El-Luhb/nvme-Carrier-for-LattePanda-Mu/README.md

# nvme Carrier for LattePanda Mu

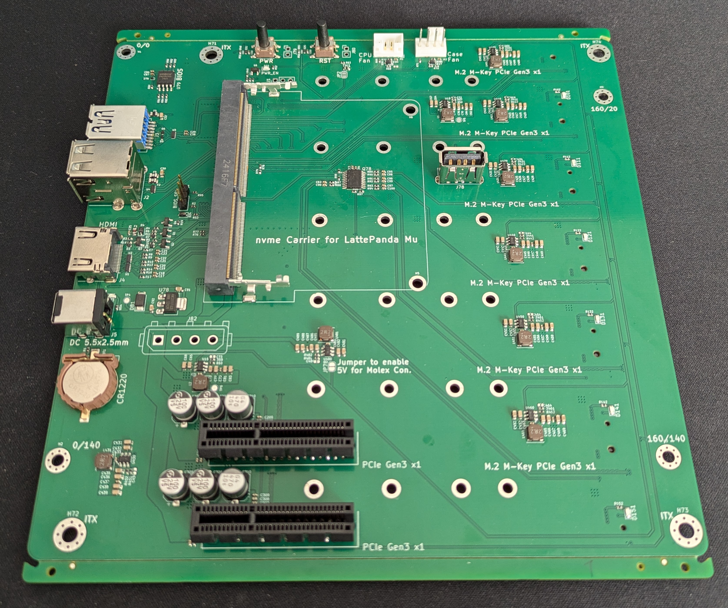
[picture p1: 1_front.jpg]


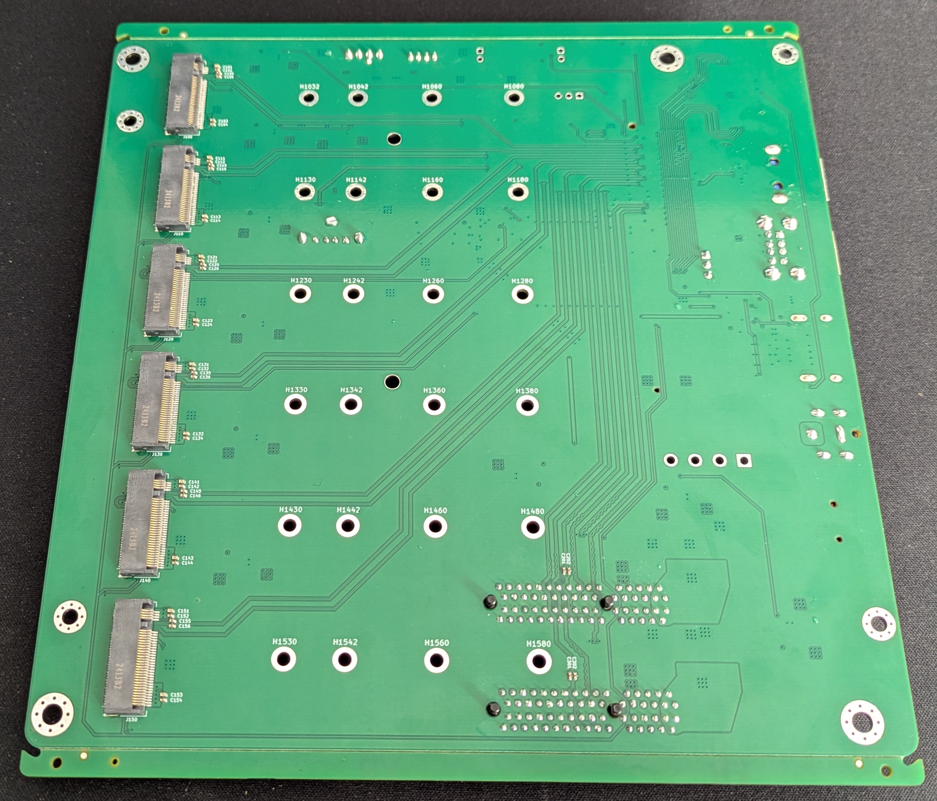
[picture p2: 1_back.jpg]
