El-Luhb/nvme-Carrier-for-LattePanda-Mu/nvme Carrier Case.STL

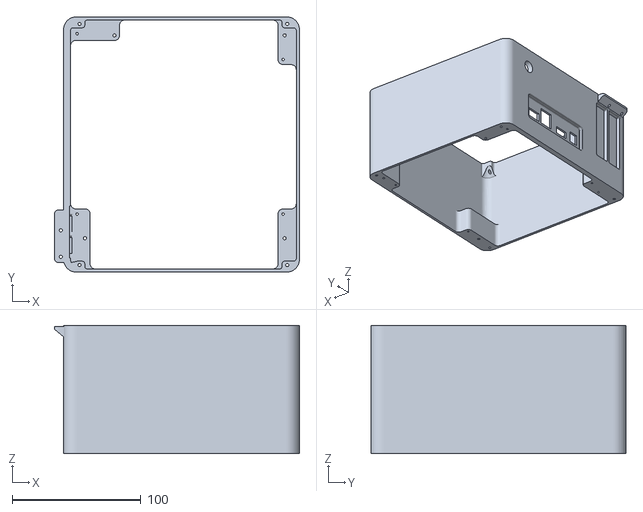
[picture p5: CAD file, 2024-12-30]
nvme Carrier Case.STL
190.2 x 198.2 x 99.5
