El-Luhb/nvme-Carrier-for-LattePanda-Mu/nvme Carrier Case Top.STL

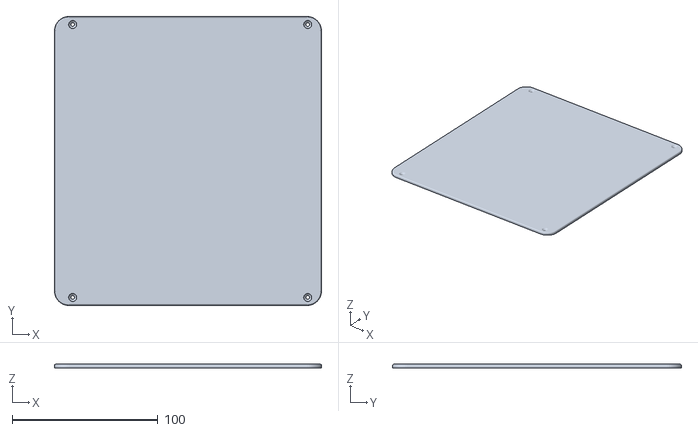
[picture p6: CAD file, 2024-12-30]
nvme Carrier Case Top.STL
183.2 x 198.2 x 2.50
