El-Luhb/nvme-Carrier-for-LattePanda-Mu/nvme Carrier Case Bottom.STL

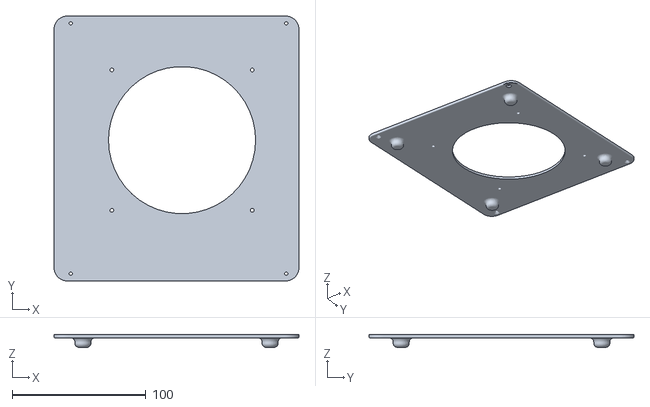
[picture p7: CAD file, 2024-12-30]
nvme Carrier Case Bottom.STL
183.2 x 198.2 x 9.50
