El-Luhb/nvme-Carrier-for-LattePanda-Mu/(threads)

Thread 1 (2024-06-23):

BIOS

El-Luhb, 2024-06-23:
need BIOS file

El-Luhb, 2024-09-19:
HSIO Lanes need to be:
- HSIO0: USB3.2 10Gbps paired with USB2 P1 (only USB 2.0 Devices work)
- HSIO1: PCIe 3.0 x1 M.2 M Key (RefClk3)
- HSIO2: PCIe 3.0 x1 M.2 M Key (RefClk4) (works with normal BIOS)
- HSIO3: PCIe 3.0 x1 M.2 M Key (Buffer0) (works with normal BIOS)
- HSIO8: PCIe 3.0 x1 M.2 M Key (Buffer1) (works with normal BIOS)
- HSIO9: PCIe 3.0 x1 M.2 M Key (Buffer2)
- HSIO10: PCIe 3.0 x1 M.2 M Key (Buffer3)
- HSIO11: PCIe 3.0 x1 (RefClk1)
- HSIO6: PCIe 3.0 x1 (RefClk0) (works with normal BIOS)

El-Luhb, 2024-09-20:
Strange behavior of the system. If all ports (including the PCIe) are occupied with nvme SSDs, 4 are recognized. However, if only one is used at a time, it is not recognized on any port.
If only the 4 ports are used that were running when fully populated, only 2 are recognized.

El-Luhb, 2024-09-22:
I tested the BIOS on the Lite Carrier. Everything works normally. Even both USB3 ports.
It seems that the configuration was not applied correctly.

El-Luhb, 2024-09-25:
Was now able to install the BIOS on the carrier (new chips, as the first ones were accidentally bricked).
Now all lanes are working. However, the USB3 prot still causes problems and if PCIe lane 6 is not occupied, PCIe lane 2 does not work. There may be other combinations that cause problems. I will test this.
It seems that a custom BIOS cannot easily be installed on the Mu itself without causing errors. At least in the configuration I need here.

alphaarea, 2024-09-30:
[LP-BS-S70NC1R200-SR-B-El-Luhb-20240930.zip](https://github.com/user-attachments/files/17187610/LP-BS-S70NC1R200-SR-B-El-Luhb-20240930.zip)

A new BIOS file has been created for you, please try to see if it works properly, and it contains a new BIOS update program.

If you already have a CH341A programmer, you can ignore the attached update utility and use the CH341A to flash the BIOS file directly into the ROM.

No matter how to update, you should completely disconnect the power supply and RTC battery to restore the BIOS default settings after the update is finished.

In addition, according to my personal test, there are some cases that after the BIOS update is completed, you need to reboot the system again to recognize the new BIOS port configuration, i.e., PCIe, USB and other port configurations correctly. The reason is unknown.

----------

If possible, please attach the actual device you are installing and the PCIe bus info in system so that we can further analyze the problem.

Use `lspci` for Linux, HWiNFO is recommended for Windows to generate hardware reports.

El-Luhb, 2024-09-30:
Thank you for the new BIOS.
Not all SSDs are recognized on the new BIOS ver. B.
Nothing was recognized at the USB 3.x port on both. I'll probably have to check the solder contacts here.
I have started my board with the same (full) configuration with both BIOS.

Here is the output from `lspci`:
BIOS ver. A:
```
root@Tower:~# lspci
00:00.0 Host bridge: Intel Corporation Device 461c
00:02.0 VGA compatible controller: Intel Corporation Alder Lake-N [UHD Graphics]
00:0a.0 Signal processing controller: Intel Corporation Platform Monitoring Technology (rev 01)
00:0d.0 USB controller: Intel Corporation Device 464e
00:14.0 USB controller: Intel Corporation Device 54ed
00:14.2 RAM memory: Intel Corporation Device 54ef
00:15.0 Serial bus controller: Intel Corporation Device 54e8
00:15.2 Serial bus controller: Intel Corporation Device 54ea
00:15.3 Serial bus controller: Intel Corporation Device 54eb
00:16.0 Communication controller: Intel Corporation Device 54e0
00:19.0 Serial bus controller: Intel Corporation Device 54c5
00:19.1 Serial bus controller: Intel Corporation Device 54c6
00:1a.0 SD Host controller: Intel Corporation Device 54c4
00:1c.0 PCI bridge: Intel Corporation Device 54b9
00:1c.2 PCI bridge: Intel Corporation Device 54ba
00:1c.3 PCI bridge: Intel Corporation Device 54bb
00:1c.6 PCI bridge: Intel Corporation Device 54be
00:1d.0 PCI bridge: Intel Corporation Device 54b0
00:1d.1 PCI bridge: Intel Corporation Device 54b1
00:1d.2 PCI bridge: Intel Corporation Device 54b2
00:1d.3 PCI bridge: Intel Corporation Device 54b3
00:1f.0 ISA bridge: Intel Corporation Device 5481
00:1f.4 SMBus: Intel Corporation Device 54a3
00:1f.5 Serial bus controller: Intel Corporation Device 54a4
01:00.0 Non-Volatile memory controller: Kingston Technology Company, Inc. A2000 NVMe SSD SM2263EN (rev 03)
02:00.0 Non-Volatile memory controller: Samsung Electronics Co Ltd NVMe SSD Controller PM9A1/PM9A3/980PRO
03:00.0 Non-Volatile memory controller: KIOXIA Corporation NVMe SSD (rev 01)
04:00.0 Ethernet controller: Intel Corporation Ethernet Controller I226-V (rev 04)
05:00.0 Non-Volatile memory controller: KIOXIA Corporation NVMe SSD (rev 01)
06:00.0 Non-Volatile memory controller: Kingston Technology Company, Inc. A2000 NVMe SSD SM2263EN (rev 03)
07:00.0 Non-Volatile memory controller: Kingston Technology Company, Inc. A2000 NVMe SSD SM2263EN (rev 03)
08:00.0 PCI bridge: ASMedia Technology Inc. ASM1182e 2-Port PCIe x1 Gen2 Packet Switch
09:03.0 PCI bridge: ASMedia Technology Inc. ASM1182e 2-Port PCIe x1 Gen2 Packet Switch
09:07.0 PCI bridge: ASMedia Technology Inc. ASM1182e 2-Port PCIe x1 Gen2 Packet Switch
0a:00.0 Ethernet controller: Realtek Semiconductor Co., Ltd. RTL8125 2.5GbE Controller (rev 05)
0b:00.0 Ethernet controller: Realtek Semiconductor Co., Ltd. RTL8125 2.5GbE Controller (rev 05)
```

BIOS ver. B:
```
root@Tower:~# lspci
00:00.0 Host bridge: Intel Corporation Device 461c
00:02.0 VGA compatible controller: Intel Corporation Alder Lake-N [UHD Graphics]
00:0a.0 Signal processing controller: Intel Corporation Platform Monitoring Technology (rev 01)
00:0d.0 USB controller: Intel Corporation Device 464e
00:14.0 USB controller: Intel Corporation Device 54ed
00:14.2 RAM memory: Intel Corporation Device 54ef
00:15.0 Serial bus controller: Intel Corporation Device 54e8
00:15.1 Serial bus controller: Intel Corporation Device 54e9
00:15.2 Serial bus controller: Intel Corporation Device 54ea
00:15.3 Serial bus controller: Intel Corporation Device 54eb
00:16.0 Communication controller: Intel Corporation Device 54e0
00:19.0 Serial bus controller: Intel Corporation Device 54c5
00:19.1 Serial bus controller: Intel Corporation Device 54c6
00:1a.0 SD Host controller: Intel Corporation Device 54c4
00:1c.0 PCI bridge: Intel Corporation Device 54b9
00:1c.2 PCI bridge: Intel Corporation Device 54ba
00:1c.3 PCI bridge: Intel Corporation Device 54bb
00:1c.6 PCI bridge: Intel Corporation Device 54be
00:1d.0 PCI bridge: Intel Corporation Device 54b0
00:1d.1 PCI bridge: Intel Corporation Device 54b1
00:1d.2 PCI bridge: Intel Corporation Device 54b2
00:1d.3 PCI bridge: Intel Corporation Device 54b3
00:1f.0 ISA bridge: Intel Corporation Device 5481
00:1f.4 SMBus: Intel Corporation Device 54a3
00:1f.5 Serial bus controller: Intel Corporation Device 54a4
02:00.0 Non-Volatile memory controller: Samsung Electronics Co Ltd NVMe SSD Controller PM9A1/PM9A3/980PRO
03:00.0 Non-Volatile memory controller: KIOXIA Corporation NVMe SSD (rev 01)
04:00.0 Ethernet controller: Intel Corporation Ethernet Controller I226-V (rev 04)
05:00.0 Non-Volatile memory controller: KIOXIA Corporation NVMe SSD (rev 01)
08:00.0 PCI bridge: ASMedia Technology Inc. ASM1182e 2-Port PCIe x1 Gen2 Packet Switch
09:03.0 PCI bridge: ASMedia Technology Inc. ASM1182e 2-Port PCIe x1 Gen2 Packet Switch
09:07.0 PCI bridge: ASMedia Technology Inc. ASM1182e 2-Port PCIe x1 Gen2 Packet Switch
0a:00.0 Ethernet controller: Realtek Semiconductor Co., Ltd. RTL8125 2.5GbE Controller (rev 05)
0b:00.0 Ethernet controller: Realtek Semiconductor Co., Ltd. RTL8125 2.5GbE Controller (rev 05)
```

El-Luhb, 2024-10-01:
some more logs.
file name --> a.ssd.1.8.net.11 --> BIOS ver. A . SSDs on HSIO 1 and 8 . Networkcard on HSIO 11
In b.ssd.1.2.3.8.9.10.net.6.11 none v2, I set the option ASPM to Auto. in the v2 it wase on Disabled (Default).
Hardware I used:
for the test with two SSDs (both Samsung PM981a) Networkcard: Noname Intel I226
Full use:
HSIO 1  - Kingston A2000
HSIO 2  - Samsung PM9A1
HSIO 3  - KIOXIA Exceris G2
HSIO 6  - Intel I226
HSIO 8  - KIOXIA Exceris G2
HSIO 9  - Kingston A2000
HSIO 10 - Kingston A2000
HSIO 11 - Networkcard with two RTL8125 (PCIe Splitter: ASM1182e)

[a.ssd.1.2.3.8.9.10.net.6.11.txt](https://github.com/user-attachments/files/17204140/a.ssd.1.2.3.8.9.10.net.6.11.txt)
[a.ssd.1.8.net.11.txt](https://github.com/user-attachments/files/17204141/a.ssd.1.8.net.11.txt)
[a.ssd.2.9.net.6.txt](https://github.com/user-attachments/files/17204143/a.ssd.2.9.net.6.txt)
[a.ssd.2.9.net.11.txt](https://github.com/user-attachments/files/17204144/a.ssd.2.9.net.11.txt)
[b.ssd.1.2.3.8.9.10.net.6.11.txt](https://github.com/user-attachments/files/17204145/b.ssd.1.2.3.8.9.10.net.6.11.txt)
[b.ssd.1.2.3.8.9.10.net.6.11-v2.txt](https://github.com/user-attachments/files/17204146/b.ssd.1.2.3.8.9.10.net.6.11-v2.txt)
[b.ssd.1.8.net.11.txt](https://github.com/user-attachments/files/17204147/b.ssd.1.8.net.11.txt)
[b.ssd.2.9.net.6.txt](https://github.com/user-attachments/files/17204148/b.ssd.2.9.net.6.txt)
[b.ssd.2.9.net.11.txt](https://github.com/user-attachments/files/17204149/b.ssd.2.9.net.11.txt)

Hope there is somethig to find here.
I don't have much time in the moment :(

alphaarea, 2024-10-14:
It looks like the PCIe ports are all recognized, is the SSD and NIC all working fine?

Also, do you mind if we make a few samples to promote LattePanda Mu?

El-Luhb, 2024-10-14:
Yes, all PCIe ports work, but not in all combinations, e.g. if HSIO 2 and 9 are used with an SSD and HSIO 11 with a NIC, only the NIC is recognized (under default settings).
I am currently playing with the BIOS settings to find possible problems.
And the USB 3.x port does not yet work.
If the PCIe devices are recognized, they reach the expected performance.

And I would be very happy if you would create and use samples of my project.

El-Luhb, 2024-10-16:
I experimented a bit and now it seems that more combinations of M.2 mounting work. At least I haven't found one that doesn't work.
What I have done:
- Removed R78 and R79
- Set PCIe clocks to:
```
Clock0 assignment -> Platform-POR
Clock1 assignment -> Enabled
Clock2 assignment -> Enabled
Clock3 assignment -> Enabled
ClkReq for Clock3 -> Platform-POR
Clock4 assignment -> Enabled
ClkReq for Clock4 -> Platform-POR
```

elshadpb, 2025-01-29:
Hi, how is your progress? As I know N100 CPU support only 5 PCIe device. So per device for per line may not work, am I right?
P.S. I also want to create my own carrier board. So I want to learn from your practice

El-Luhb, 2025-01-29:
The system runs (almost without problems) with up to 8 PCIe devices.
The limitation of 5 devices refers to the standard BIOS and the available CLK lanes.
With the help of a CLK buffer IC (9DBL411BGLFT on this carrier), it is possible to extend the CLK lanes. What is then also important is an adjusted BIOS in which the PCIe lanes are divided up accordingly.

elshadpb, 2025-01-29:
Thanks for explanation

elshadpb, 2025-01-30:
Can I ask from where you got BIOS for your board? Are you developed your own BIOS?

El-Luhb, 2025-01-30:
I got the BIOS from alphaarea. see [above](https://github.com/El-Luhb/nvme-Carrier-for-LattePanda-Mu/issues/1#issuecomment-2382645719).
You can request a BIOS by sending specific configuration requirements to [techsupport@lattepanda.com](mailto:techsupport@lattepanda.com)

elshadpb, 2025-01-30:
@El-Luhb
I want board with 1xUSB3, 1xNIC2.5, 2xSATA, 1xM.2-E(x1), 2xM.2-M(x2). Total 9 PCI lanes.
As I understand from your board USB2 do not need PCIe lanes.
As I am absolute noob in electronics I want to adapt your board or will use your board and use M.2-NIC, M.2-SATA adapters.
You are doing great work.

El-Luhb, 2025-02-02:
@elshadpb
And yes, the USB2.0 connections are available separately.
That's the reason why I designed this board the way I did. For example, a SATA extension in the upper PCIe slot and Ethernet in the lower slot.

El-Luhb, 2025-02-02:
The USB 3.x port works with a correspondingly correcting cable.
The error was swapped connections. These have been corrected as of v1.0.

The latest BIOS provided by alphaarea ([Link](https://github.com/El-Luhb/nvme-Carrier-for-LattePanda-Mu/issues/1#issuecomment-2382645719))  is operational and so far stable for me.
Unfortunately ASPM does not work there yet (at least not for me).

Closed 2025-02-02.

Thread 4 (2024-06-23):

M.2 Size of Mounting holes correct?

El-Luhb, 2024-06-23:

Closed 2024-09-19.

Thread 7 (2024-09-19):

Ground Pin internal USB and MountingPin PCIe Connectros

El-Luhb, 2024-09-19:
Ground Pin of the internal USB hits the M.2 SSD #1 and the MountingPin of the PCIe Connectros hits the M.2 SSD #5
#0, #2, #3, #4 fits

Thread 10 (2024-12-13):

Question: Does kicad has something like area rules to reuse layout of submodules?

konosubakonoakua, 2024-12-13:
just a wonder, because I have used this functionality in Altium.
Have you use same functionality in kicad? thank your answer in advance😊

El-Luhb, 2024-12-14:
Yes, there are some options for this. But I didn't use them. The reason for this was simply that I didn't have the time to find out how it works. For me, it was enough to just copy and paste.

konosubakonoakua, 2024-12-17:
Thank you.

Closed 2024-12-17.
