El-Luhb/nvme-Carrier-for-LattePanda-Mu/PCB/4 Layer nvme Carrier all M2/BIOS.kicad_sch

## KiCad design PCB/4 Layer nvme Carrier all M2/BIOS.kicad_sch (2025-02-06)

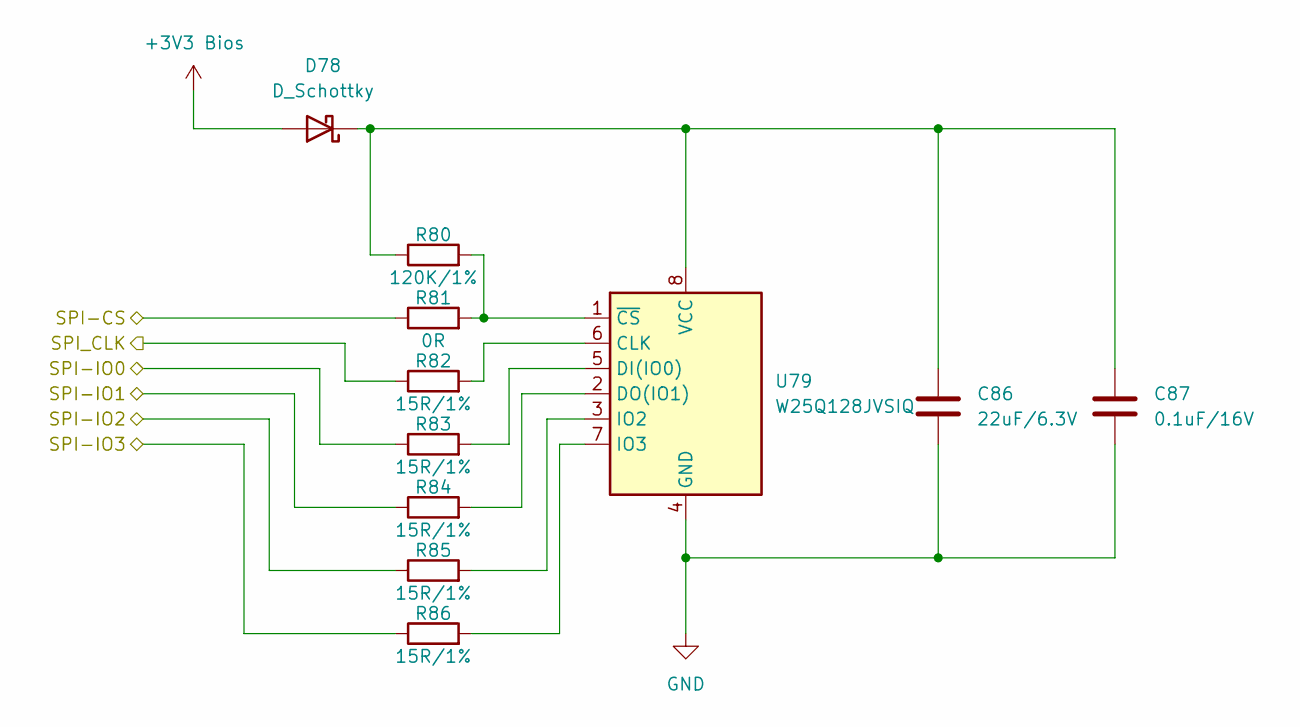
[picture p18: schematic BIOS.kicad_sch]

Parts:
C86: 22uF/6.3V; C_0402_1005Metric; Part# C105226; LCSC Part # C105226
C87: 0.1uF/16V; C_0402_1005Metric; Part# C83056; LCSC Part # C83056
D78: D_Schottky; D_SOD-923; Part# C239637; LCSC Part # C239637
R80: 120K/1%; R_0402_1005Metric; Part# C93945; LCSC Part # C93945
R81: 0R; R_0402_1005Metric; Part# C325377; LCSC Part # C325377
R82, R83, R84, R85, R86: 15R/1%; R_0402_1005Metric; Part# C138052; LCSC Part # C138052
U79: W25Q128JVSIQ; SOIC-8_5.23x5.23mm_P1.27mm; Part# C97521; LCSC Part # C97521

Connections:
+3V3 Bios: D78.2 (A)
GND: C86.2, C87.2, U79.4 (GND)
unnamed: C86.1, C87.1, D78.1 (K), R80.1, U79.8 (VCC)
unnamed: R80.2, R81.2, U79.1 (~CS)
unnamed: R82.2, U79.6 (CLK)
unnamed: R83.2, U79.5 (DI(IO0))
unnamed: R84.2, U79.2 (DO(IO1))
unnamed: R85.2, U79.3 (IO2)
unnamed: R86.2, U79.7 (IO3)
SPI-CS: R81.1
SPI-IO0: R83.1
SPI-IO1: R84.1
SPI-IO2: R85.1
SPI-IO3: R86.1
SPI_CLK: R82.1
