El-Luhb/nvme-Carrier-for-LattePanda-Mu/PCB/4 Layer nvme Carrier all M2/HDMI DP.kicad_sch

## KiCad design PCB/4 Layer nvme Carrier all M2/HDMI DP.kicad_sch (2025-02-06)

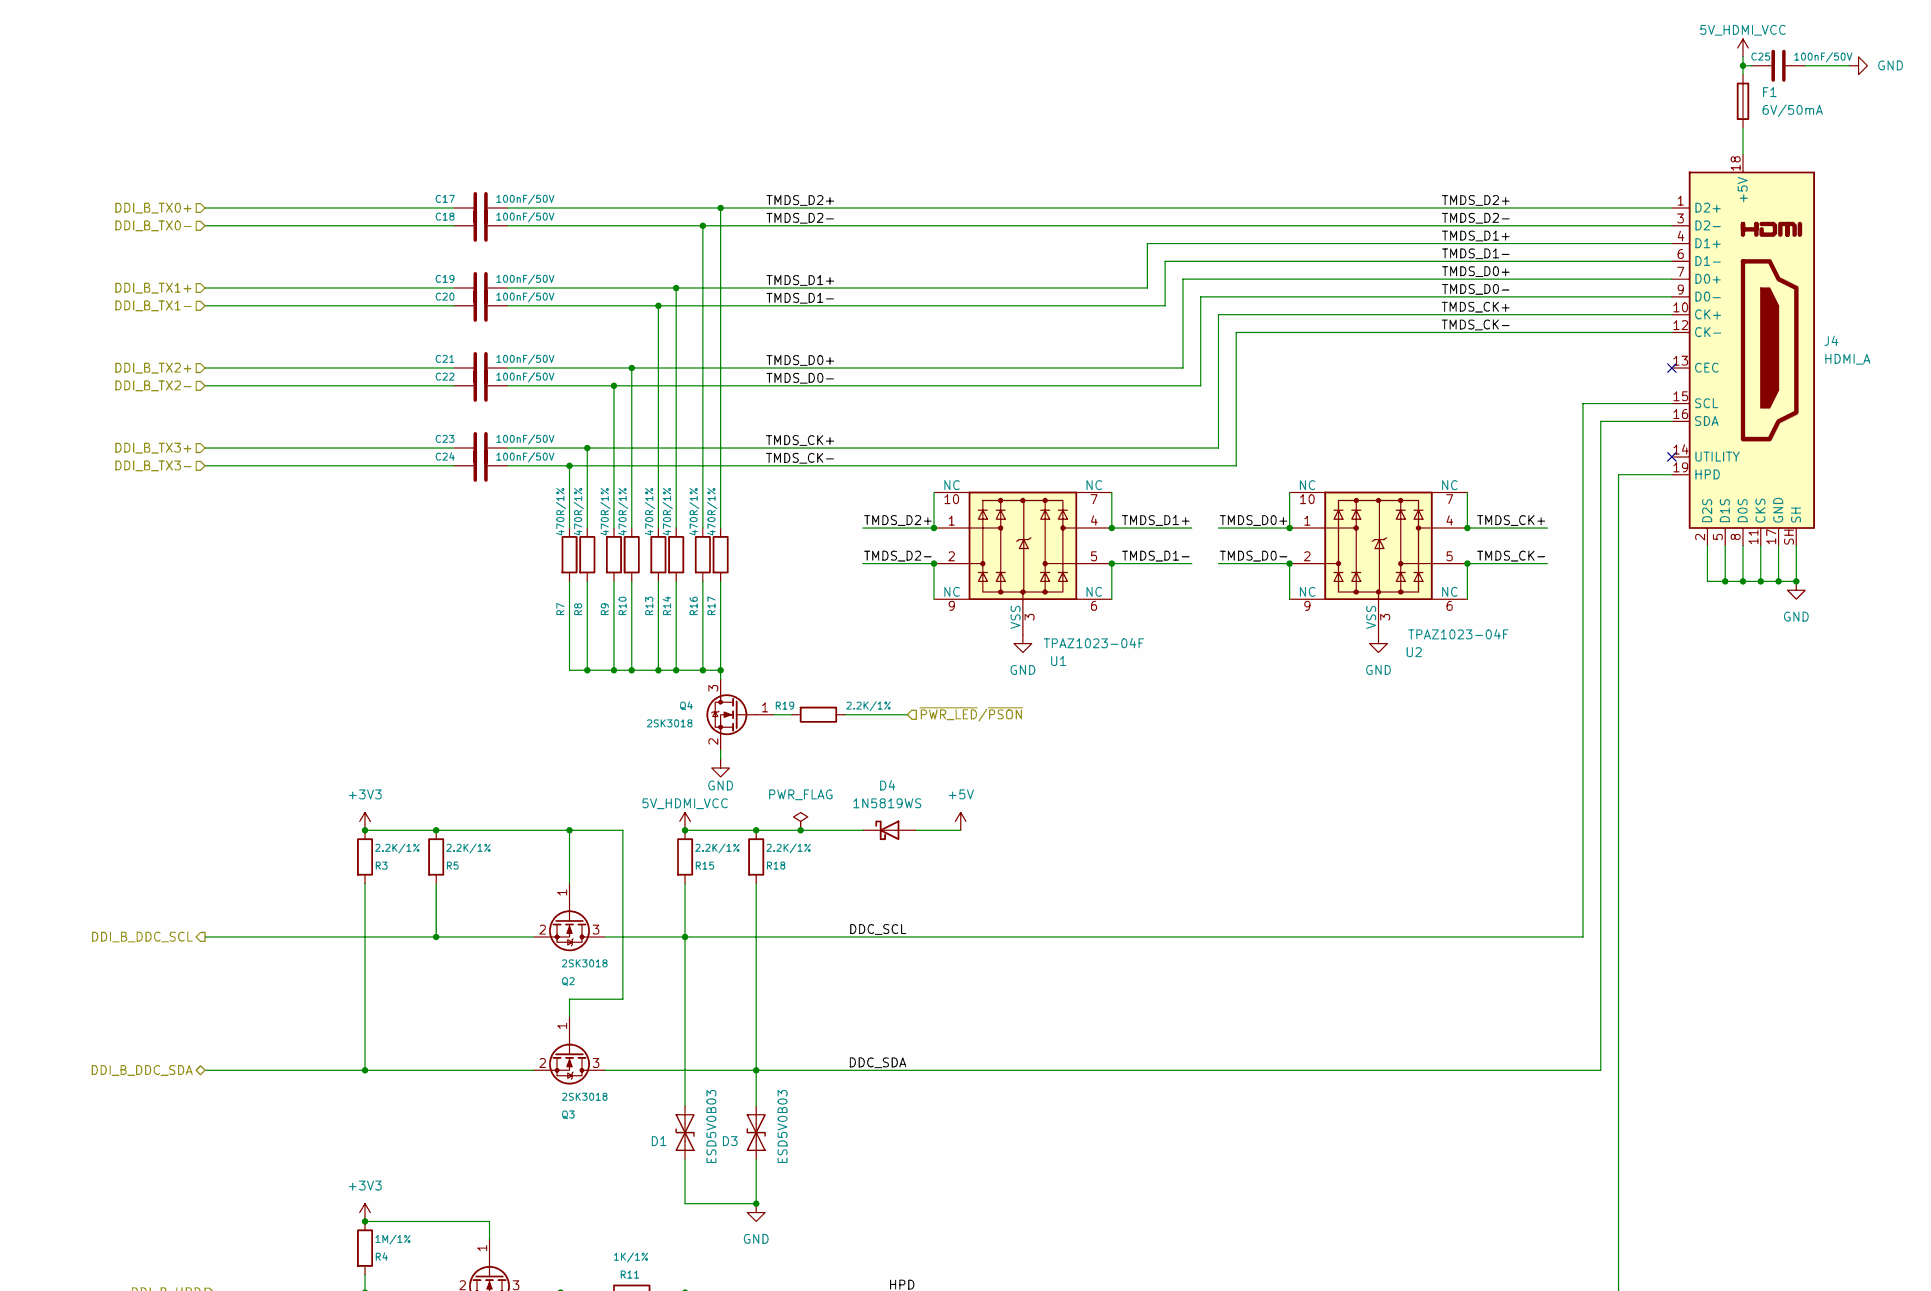
[picture p20: schematic HDMI DP.kicad_sch, part in row 1, column 1]

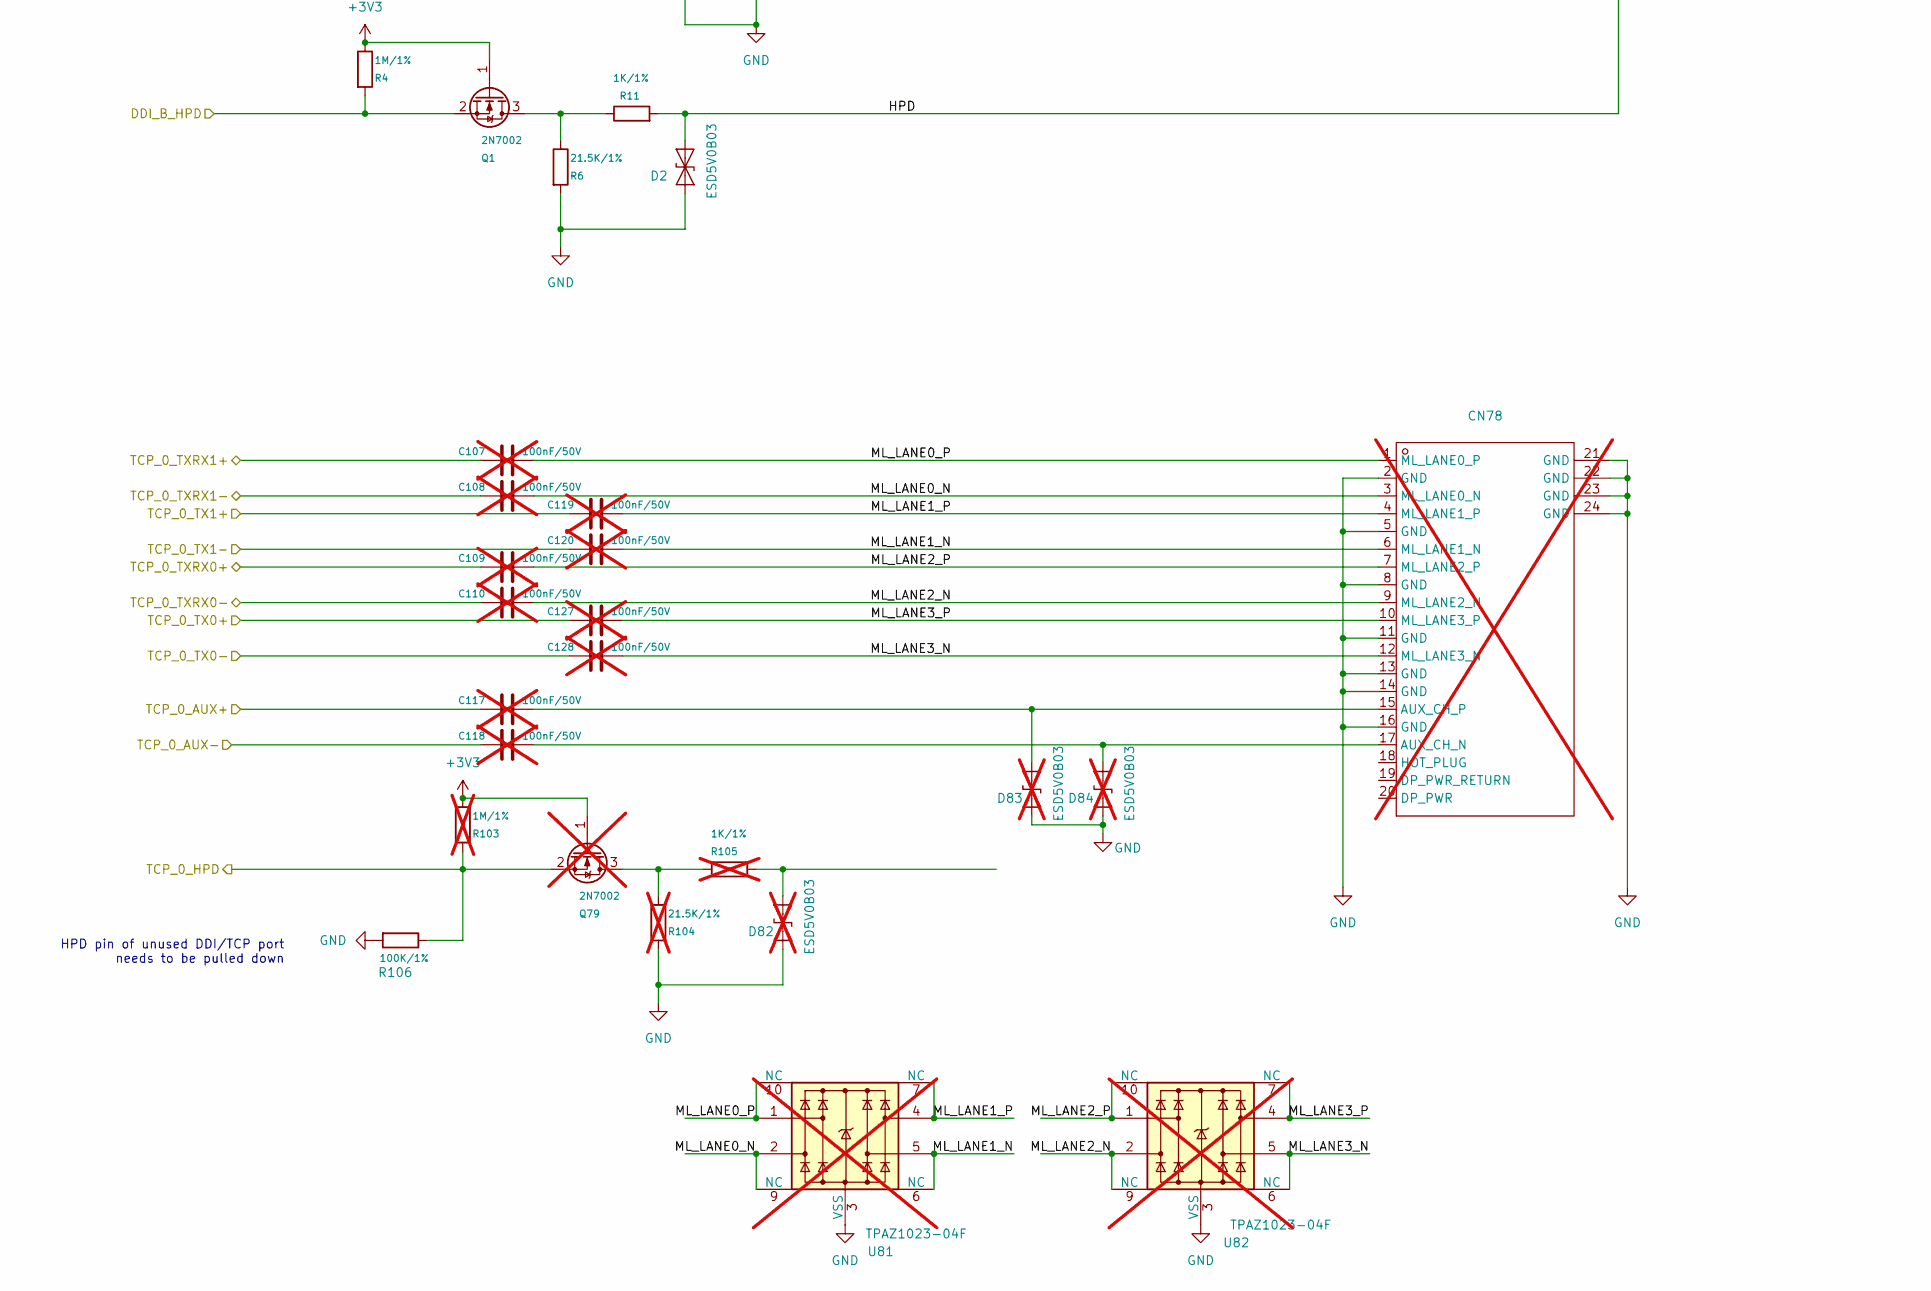
[picture p21: schematic HDMI DP.kicad_sch, part in row 2, column 1]

Parts:
C17, C18, C19, C20, C21, C22, C23, C24, C25: 100nF/50V; C_0402_1005Metric; Part# C77020; LCSC Part # C77020
C107, C108, C109, C110, C117, C118, C119, C120, C127, C128: 100nF/50V; C_0402_1005Metric; Part# C77020; LCSC Part # C77020; not fitted
CN78: DP-SMD_HYC16-DP20-178; Manufacturer Part HYC16-DP20-178; LCSC Part Name HYC16-DP20-178; not fitted
D1, D2, D3: ESD5V0B03; D_0402_1005Metric; Part# C521894; LCSC Part # C521894
D4: 1N5819WS; D_SOD-323; Part# C2828425; LCSC Part # C2828425
D82, D83, D84: ESD5V0B03; D_0402_1005Metric; Part# C521894; LCSC Part # C521894; not fitted
F1: 6V/50mA; R_0603_1608Metric; Part# C7472536; LCSC Part # C7472536
J4: HDMI_A; HDMI_A_Molex_208658-1001_Horizontal; Part# C916313; LCSC Part # C2858275
Q1: 2N7002; SOT-23; Part# C7603342; LCSC Part # C7603342
Q2, Q3, Q4: 2SK3018; SOT-23; Part# C475593; LCSC Part # C475593
Q79: 2N7002; SOT-23; Part# C7603342; LCSC Part # C7603342; not fitted
R3, R5, R15, R18, R19: 2.2K/1%; R_0402_1005Metric; Part# C114762; LCSC Part # C114762
R4: 1M/1%; R_0402_1005Metric; Part# C138033; LCSC Part # C138033
R6: 21.5K/1%; R_0402_1005Metric; Part# C185442; LCSC Part # C185442
R7, R8, R9, R10, R13, R14, R16, R17: 470R/1%; R_0402_1005Metric; Part# C114877; LCSC Part # C114877
R11: 1K/1%; R_0402_1005Metric; Part# C106235; LCSC Part # C106235
R103: 1M/1%; R_0402_1005Metric; Part# C138033; LCSC Part # C138033; not fitted
R104: 21.5K/1%; R_0402_1005Metric; Part# C185442; LCSC Part # C185442; not fitted
R105: 1K/1%; R_0402_1005Metric; Part# C106235; LCSC Part # C106235; not fitted
R106: 100K/1%; R_0402_1005Metric; Part# C60491; LCSC Part # C60491
U1, U2: TPAZ1023-04F; Diodes_UDFN-10_1.0x2.5mm_P0.5mm; Part# C2827676; LCSC Part # C2827676
U81, U82: TPAZ1023-04F; Diodes_UDFN-10_1.0x2.5mm_P0.5mm; Part# C2827676; LCSC Part # C2827676; not fitted

Connections:
5V_HDMI_VCC: C25.1, D4.1 (K), F1.1, R15.1, R18.1
+3V3: Q1.1 (G), Q2.1 (G), Q3.1 (G), Q79.1 (G), R3.1, R4.1, R5.1, R103.1
+5V: D4.2 (A)
DDC_SCL: D1.2 (A2), J4.15 (SCL), Q2.3 (D), R15.2
DDC_SDA: D3.2 (A2), J4.16 (SDA), Q3.3 (D), R18.2
DDI_B_DDC_SCL: Q2.2 (S), R5.2
DDI_B_DDC_SDA: Q3.2 (S), R3.2
DDI_B_HPD: Q1.2 (S), R4.2
DDI_B_TX0+: C17.1
DDI_B_TX0-: C18.1
DDI_B_TX1+: C19.1
DDI_B_TX1-: C20.1
DDI_B_TX2+: C21.1
DDI_B_TX2-: C22.1
DDI_B_TX3+: C23.1
DDI_B_TX3-: C24.1
GND: C25.2, CN78.2 (GND), CN78.5 (GND), CN78.8 (GND), CN78.11 (GND), CN78.13 (GND), CN78.14 (GND), CN78.16 (GND), CN78.21 (GND), CN78.22 (GND), CN78.23 (GND), CN78.24 (GND), D1.1 (A1), D2.1 (A1), D3.1 (A1), D82.1 (A1), D83.1 (A1), D84.1 (A1), J4.2 (D2S), J4.5 (D1S), J4.8 (D0S), J4.11 (CKS), J4.17 (GND), J4.SH, Q4.2 (S), R6.2, R104.2, R106.2, U1.3 (VSS), U1.8 (VSS), U2.3 (VSS), U2.8 (VSS), U81.3 (VSS), U81.8 (VSS), U82.3 (VSS), U82.8 (VSS)
HPD: D2.2 (A2), J4.19 (HPD), R11.2
ML_LANE0_N: C108.2, CN78.3 (ML_LANE0_N), U81.2, U81.9 (NC)
ML_LANE0_P: C107.2, CN78.1 (ML_LANE0_P), U81.1, U81.10 (NC)
ML_LANE1_N: C120.2, CN78.6 (ML_LANE1_N), U81.5, U81.6 (NC)
ML_LANE1_P: C119.2, CN78.4 (ML_LANE1_P), U81.4, U81.7 (NC)
ML_LANE2_N: C110.2, CN78.9 (ML_LANE2_N), U82.2, U82.9 (NC)
ML_LANE2_P: C109.2, CN78.7 (ML_LANE2_P), U82.1, U82.10 (NC)
ML_LANE3_N: C128.2, CN78.12 (ML_LANE3_N), U82.5, U82.6 (NC)
ML_LANE3_P: C127.2, CN78.10 (ML_LANE3_P), U82.4, U82.7 (NC)
unnamed: C117.2, CN78.15 (AUX_CH_P), D83.2 (A2)
unnamed: C118.2, CN78.17 (AUX_CH_N), D84.2 (A2)
unnamed: D82.2 (A2), R105.2
unnamed: F1.2, J4.18 (+5V)
unnamed: Q1.3 (D), R6.1, R11.1
unnamed: Q4.1 (G), R19.2
unnamed: Q4.3 (D), R7.2, R8.2, R9.2, R10.2, R13.2, R14.2, R16.2, R17.2
unnamed: Q79.3 (D), R104.1, R105.1
TCP_0_AUX+: C117.1
TCP_0_AUX-: C118.1
TCP_0_HPD: Q79.2 (S), R103.2, R106.1
TCP_0_TX0+: C127.1
TCP_0_TX0-: C128.1
TCP_0_TX1+: C119.1
TCP_0_TX1-: C120.1
TCP_0_TXRX0+: C109.1
TCP_0_TXRX0-: C110.1
TCP_0_TXRX1+: C107.1
TCP_0_TXRX1-: C108.1
TMDS_CK+: C23.2, J4.10 (CK+), R8.1, U2.4, U2.7 (NC)
TMDS_CK-: C24.2, J4.12 (CK-), R7.1, U2.5, U2.6 (NC)
TMDS_D0+: C21.2, J4.7 (D0+), R10.1, U2.1, U2.10 (NC)
TMDS_D0-: C22.2, J4.9 (D0-), R9.1, U2.2, U2.9 (NC)
TMDS_D1+: C19.2, J4.4 (D1+), R14.1, U1.4, U1.7 (NC)
TMDS_D1-: C20.2, J4.6 (D1-), R13.1, U1.5, U1.6 (NC)
TMDS_D2+: C17.2, J4.1 (D2+), R17.1, U1.1, U1.10 (NC)
TMDS_D2-: C18.2, J4.3 (D2-), R16.1, U1.2, U1.9 (NC)
~PWR_LED/~PSON: R19.1

Notes on the sheet:
HPD pin of unused DDI/TCP port needs to be pulled down
