El-Luhb/nvme-Carrier-for-LattePanda-Mu/PCB/4 Layer nvme Carrier all M2/LattePanda Module.kicad_sch

## KiCad design PCB/4 Layer nvme Carrier all M2/LattePanda Module.kicad_sch (2025-02-06)

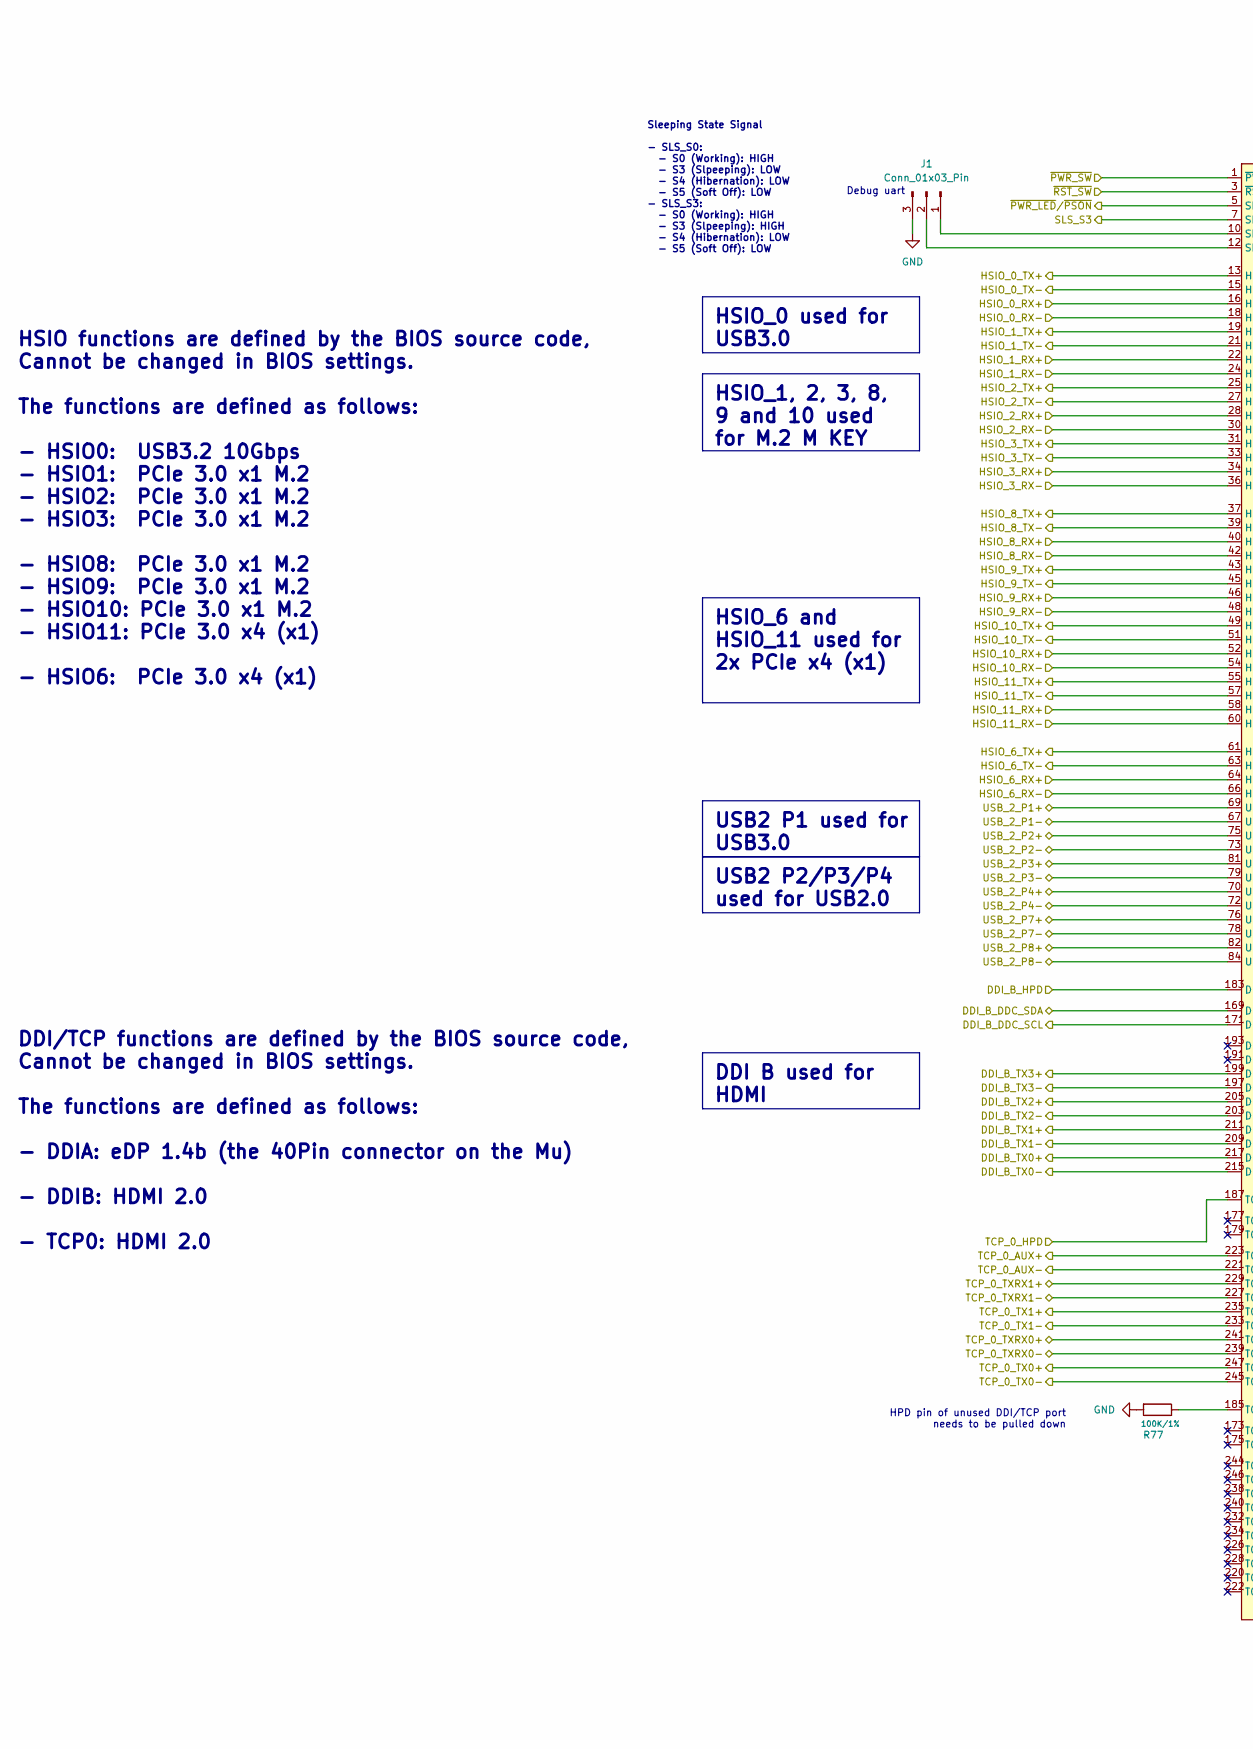
[picture p22: schematic LattePanda Module.kicad_sch, part in row 1, column 1]

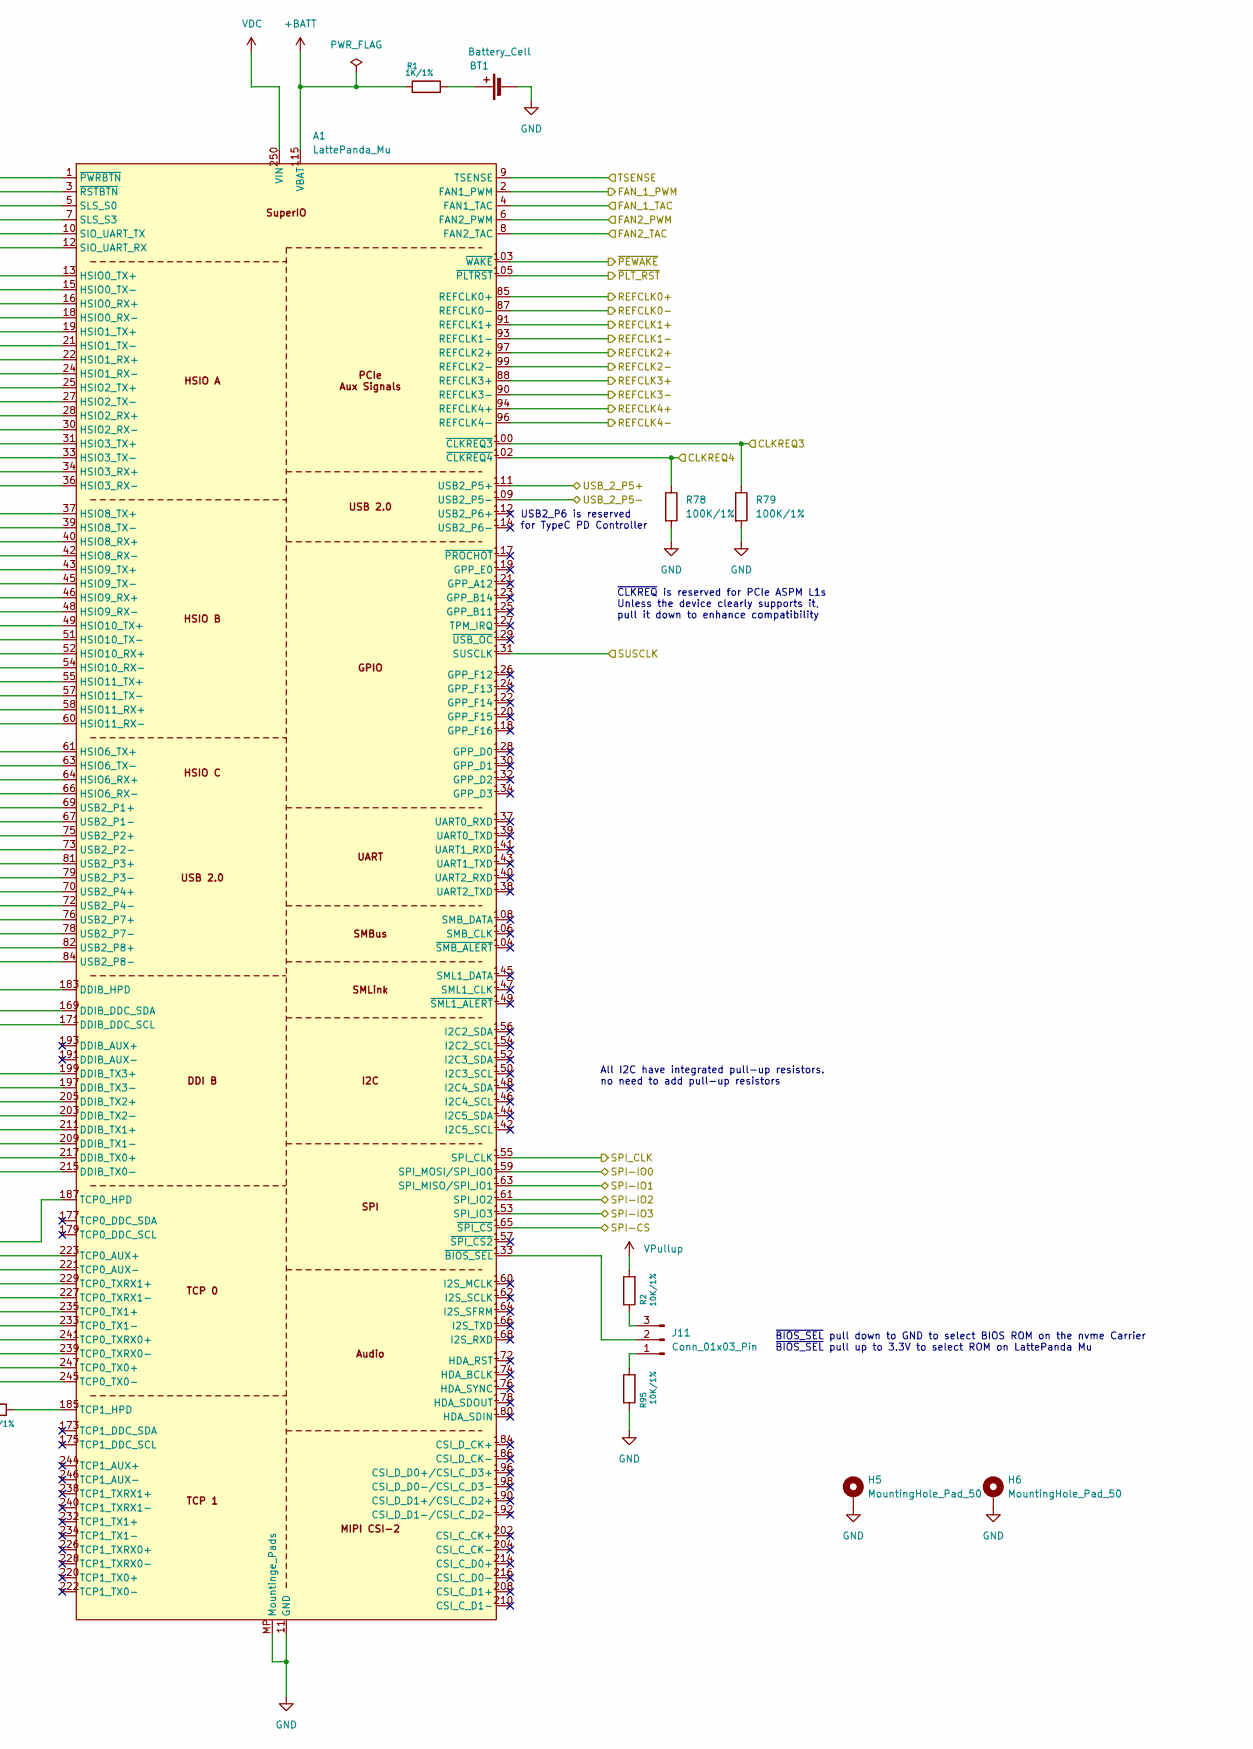
[picture p23: schematic LattePanda Module.kicad_sch, part in row 1, column 2]

Parts:
A1: LattePanda_Mu; LattePanda_Module_H8.0mm_Horizontal; Part# C962126; LCSC Part # C962126
BT1: Battery_Cell; Battery_Holder_CR1220_S8411-45R; Part# C70381; LCSC Part # C70381
H5, H6: MountingHole_Pad_50; MountingHole_3mm_M2_Pad_TopOnly; MPN SMTWEM250STR; LCSC Part # C5301799
J1, J11: Conn_01x03_Pin; PinHeader_1x03_P2.54mm_Vertical; MPN PZ2.54-1*3
R1: 1K/1%; R_0402_1005Metric; Part# C106235; LCSC Part # C106235
R2, R95: 10K/1%; R_0402_1005Metric; Part# C60490; LCSC Part # C60490
R77, R78, R79: 100K/1%; R_0402_1005Metric; Part# C60491; LCSC Part # C60491

Connections:
+BATT: A1.115 (VBAT), R1.1
CLKREQ3: A1.100 (~CLKREQ3), R79.1
CLKREQ4: A1.102 (~CLKREQ4), R78.1
DDI_B_DDC_SCL: A1.171 (DDIB_DDC_SCL)
DDI_B_DDC_SDA: A1.169 (DDIB_DDC_SDA)
DDI_B_HPD: A1.183 (DDIB_HPD)
DDI_B_TX0+: A1.217 (DDIB_TX0+)
DDI_B_TX0-: A1.215 (DDIB_TX0-)
DDI_B_TX1+: A1.211 (DDIB_TX1+)
DDI_B_TX1-: A1.209 (DDIB_TX1-)
DDI_B_TX2+: A1.205 (DDIB_TX2+)
DDI_B_TX2-: A1.203 (DDIB_TX2-)
DDI_B_TX3+: A1.199 (DDIB_TX3+)
DDI_B_TX3-: A1.197 (DDIB_TX3-)
FAN2_PWM: A1.6 (FAN2_PWM)
FAN2_TAC: A1.8 (FAN2_TAC)
FAN_1_PWM: A1.2 (FAN1_PWM)
FAN_1_TAC: A1.4 (FAN1_TAC)
GND: A1.11 (GND), A1.14 (GND), A1.17 (GND), A1.20 (GND), A1.23 (GND), A1.26 (GND), A1.29 (GND), A1.32 (GND), A1.35 (GND), A1.38 (GND), A1.41 (GND), A1.44 (GND), A1.47 (GND), A1.50 (GND), A1.53 (GND), A1.56 (GND), A1.59 (GND), A1.62 (GND), A1.65 (GND), A1.68 (GND), A1.71 (GND), A1.74 (GND), A1.77 (GND), A1.80 (GND), A1.83 (GND), A1.86 (GND), A1.89 (GND), A1.92 (GND), A1.95 (GND), A1.98 (GND), A1.101 (GND), A1.107 (GND), A1.110 (GND), A1.113 (GND), A1.116 (GND), A1.135 (GND), A1.136 (GND), A1.151 (GND), A1.158 (GND), A1.167 (GND), A1.170 (GND), A1.181 (GND), A1.182 (GND), A1.188 (GND), A1.189 (GND), A1.194 (GND), A1.195 (GND), A1.200 (GND), A1.201 (GND), A1.206 (GND), A1.207 (GND), A1.212 (GND), A1.213 (GND), A1.218 (GND), A1.219 (GND), A1.224 (GND), A1.225 (GND), A1.230 (GND), A1.231 (GND), A1.236 (GND), A1.237 (GND), A1.242 (GND), A1.243 (GND), A1.248 (GND), A1.249 (GND), A1.MP (Mountinge_Pads), BT1.2 (-), H5.1, H6.1, J1.3, R77.2, R78.2, R79.2, R95.1
HSIO_0_RX+: A1.16 (HSIO0_RX+)
HSIO_0_RX-: A1.18 (HSIO0_RX-)
HSIO_0_TX+: A1.13 (HSIO0_TX+)
HSIO_0_TX-: A1.15 (HSIO0_TX-)
HSIO_1_RX+: A1.22 (HSIO1_RX+)
HSIO_1_RX-: A1.24 (HSIO1_RX-)
HSIO_1_TX+: A1.19 (HSIO1_TX+)
HSIO_1_TX-: A1.21 (HSIO1_TX-)
HSIO_2_RX+: A1.28 (HSIO2_RX+)
HSIO_2_RX-: A1.30 (HSIO2_RX-)
HSIO_2_TX+: A1.25 (HSIO2_TX+)
HSIO_2_TX-: A1.27 (HSIO2_TX-)
HSIO_3_RX+: A1.34 (HSIO3_RX+)
HSIO_3_RX-: A1.36 (HSIO3_RX-)
HSIO_3_TX+: A1.31 (HSIO3_TX+)
HSIO_3_TX-: A1.33 (HSIO3_TX-)
HSIO_6_RX+: A1.64 (HSIO6_RX+)
HSIO_6_RX-: A1.66 (HSIO6_RX-)
HSIO_6_TX+: A1.61 (HSIO6_TX+)
HSIO_6_TX-: A1.63 (HSIO6_TX-)
HSIO_8_RX+: A1.40 (HSIO8_RX+)
HSIO_8_RX-: A1.42 (HSIO8_RX-)
HSIO_8_TX+: A1.37 (HSIO8_TX+)
HSIO_8_TX-: A1.39 (HSIO8_TX-)
HSIO_9_RX+: A1.46 (HSIO9_RX+)
HSIO_9_RX-: A1.48 (HSIO9_RX-)
HSIO_9_TX+: A1.43 (HSIO9_TX+)
HSIO_9_TX-: A1.45 (HSIO9_TX-)
HSIO_10_RX+: A1.52 (HSIO10_RX+)
HSIO_10_RX-: A1.54 (HSIO10_RX-)
HSIO_10_TX+: A1.49 (HSIO10_TX+)
HSIO_10_TX-: A1.51 (HSIO10_TX-)
HSIO_11_RX+: A1.58 (HSIO11_RX+)
HSIO_11_RX-: A1.60 (HSIO11_RX-)
HSIO_11_TX+: A1.55 (HSIO11_TX+)
HSIO_11_TX-: A1.57 (HSIO11_TX-)
unnamed: A1.10 (SIO_UART_TX), J1.1
unnamed: A1.12 (SIO_UART_RX), J1.2
unnamed: A1.133 (~BIOS_SEL), J11.2
unnamed: A1.185 (TCP1_HPD), R77.1
unnamed: BT1.1 (+), R1.2
unnamed: J11.1, R95.2
unnamed: J11.3, R2.1
REFCLK0+: A1.85 (REFCLK0+)
REFCLK0-: A1.87 (REFCLK0-)
REFCLK1+: A1.91 (REFCLK1+)
REFCLK1-: A1.93 (REFCLK1-)
REFCLK2+: A1.97 (REFCLK2+)
REFCLK2-: A1.99 (REFCLK2-)
REFCLK3+: A1.88 (REFCLK3+)
REFCLK3-: A1.90 (REFCLK3-)
REFCLK4+: A1.94 (REFCLK4+)
REFCLK4-: A1.96 (REFCLK4-)
SLS_S3: A1.7 (SLS_S3)
SPI-CS: A1.165 (~SPI_CS)
SPI-IO0: A1.159 (SPI_MOSI/SPI_IO0)
SPI-IO1: A1.163 (SPI_MISO/SPI_IO1)
SPI-IO2: A1.161 (SPI_IO2)
SPI-IO3: A1.153 (SPI_IO3)
SPI_CLK: A1.155 (SPI_CLK)
SUSCLK: A1.131 (SUSCLK)
TCP_0_AUX+: A1.223 (TCP0_AUX+)
TCP_0_AUX-: A1.221 (TCP0_AUX-)
TCP_0_HPD: A1.187 (TCP0_HPD)
TCP_0_TX0+: A1.247 (TCP0_TX0+)
TCP_0_TX0-: A1.245 (TCP0_TX0-)
TCP_0_TX1+: A1.235 (TCP0_TX1+)
TCP_0_TX1-: A1.233 (TCP0_TX1-)
TCP_0_TXRX0+: A1.241 (TCP0_TXRX0+)
TCP_0_TXRX0-: A1.239 (TCP0_TXRX0-)
TCP_0_TXRX1+: A1.229 (TCP0_TXRX1+)
TCP_0_TXRX1-: A1.227 (TCP0_TXRX1-)
TSENSE: A1.9 (TSENSE)
USB_2_P1+: A1.69 (USB2_P1+)
USB_2_P1-: A1.67 (USB2_P1-)
USB_2_P2+: A1.75 (USB2_P2+)
USB_2_P2-: A1.73 (USB2_P2-)
USB_2_P3+: A1.81 (USB2_P3+)
USB_2_P3-: A1.79 (USB2_P3-)
USB_2_P4+: A1.70 (USB2_P4+)
USB_2_P4-: A1.72 (USB2_P4-)
USB_2_P5+: A1.111 (USB2_P5+)
USB_2_P5-: A1.109 (USB2_P5-)
USB_2_P7+: A1.76 (USB2_P7+)
USB_2_P7-: A1.78 (USB2_P7-)
USB_2_P8+: A1.82 (USB2_P8+)
USB_2_P8-: A1.84 (USB2_P8-)
VDC: A1.250 (VIN), A1.251 (VIN), A1.252 (VIN), A1.253 (VIN), A1.254 (VIN), A1.255 (VIN), A1.256 (VIN), A1.257 (VIN), A1.258 (VIN), A1.259 (VIN), A1.260 (VIN)
VPullup: R2.2
~PEWAKE: A1.103 (~WAKE)
~PLT_RST: A1.105 (~PLTRST)
~PWR_LED/~PSON: A1.5 (SLS_S0)
~PWR_SW: A1.1 (~PWRBTN)
~RST_SW: A1.3 (~RSTBTN)

Notes on the sheet:
HSIO_0 used for USB3.0
HSIO_1, 2, 3, 8, 9 and 10 used for M.2 M KEY
USB2 P2/P3/P4 used for USB2.0
DDI B used for HDMI
HSIO_6 and HSIO_11 used for 2x PCIe x4 (x1)
USB2 P1 used for USB3.0
HSIO functions are defined by the BIOS source code, Cannot be changed in BIOS settings. The functions are defined as follows: - HSIO0: USB3.2 10Gbps - HSIO1: PCIe 3.0 x1 M.2 - HSIO2: PCIe 3.0 x1 M.2 - HSIO3: PCIe 3.0 x1 M.2 - HSIO8: PCIe 3.0 x1 M.2 - HSIO9: PCIe 3.0 x1 M.2 - HSIO10: PCIe 3.0 x1 M.2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
~{BIOS_SEL} pull down to GND to select BIOS ROM on the nvme Carrier ~{BIOS_SEL} pull up to 3.3V to select ROM on LattePanda Mu
DDI/TCP functions are defined by the BIOS source code, Cannot be changed in BIOS settings. The functions are defined as follows: - DDIA: eDP 1.4b (the 40Pin connector on the Mu) - DDIB: HDMI 2.0 - TCP0: HDMI 2.0
Sleeping State Signal - SLS_S0: - S0 (Working): HIGH - S3 (Slpeeping): LOW - S4 (Hibernation): LOW - S5 (Soft Off): LOW - SLS_S3: - S0 (Working): HIGH - S3 (Slpeeping): HIGH - S4 (Hibernation): LOW - S5 (Soft Off): LOW
USB2_P6 is reserved for TypeC PD Controller
All I2C have integrated pull-up resistors. no need to add pull-up resistors
Debug uart
~{CLKREQ} is reserved for PCIe ASPM L1s Unless the device clearly supports it, pull it down to enhance compatibility
HPD pin of unused DDI/TCP port needs to be pulled down
