El-Luhb/nvme-Carrier-for-LattePanda-Mu/PCB/4 Layer nvme Carrier all M2/M.2 E&M-Key.kicad_sch

## KiCad design PCB/4 Layer nvme Carrier all M2/M.2 E&M-Key.kicad_sch (2025-02-06)

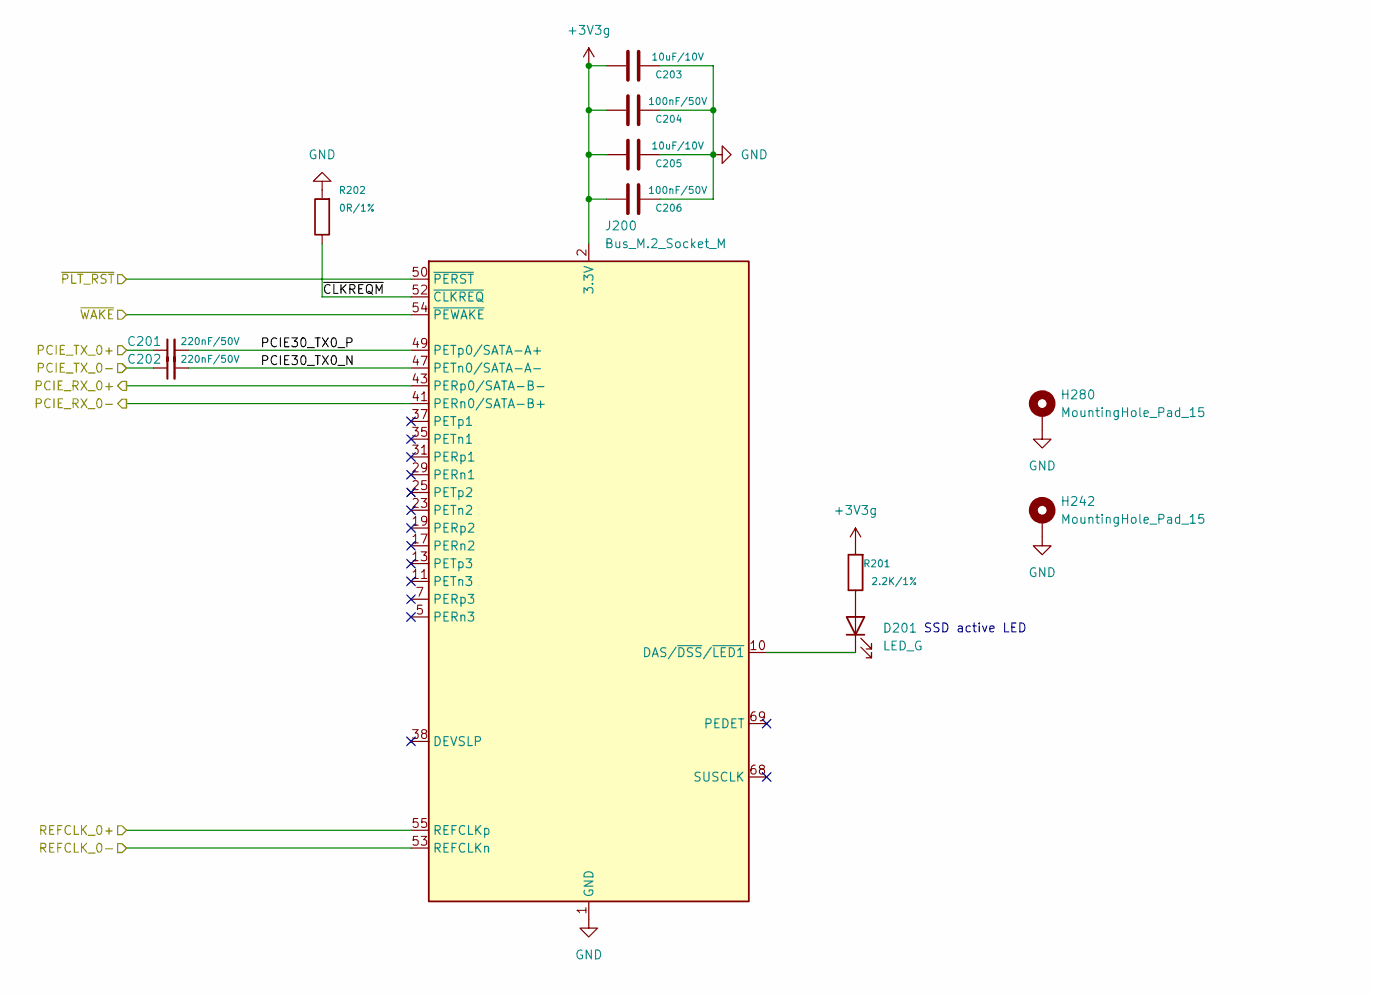
[picture p24: schematic M.2 E&M-Key.kicad_sch, part in row 1, column 1]

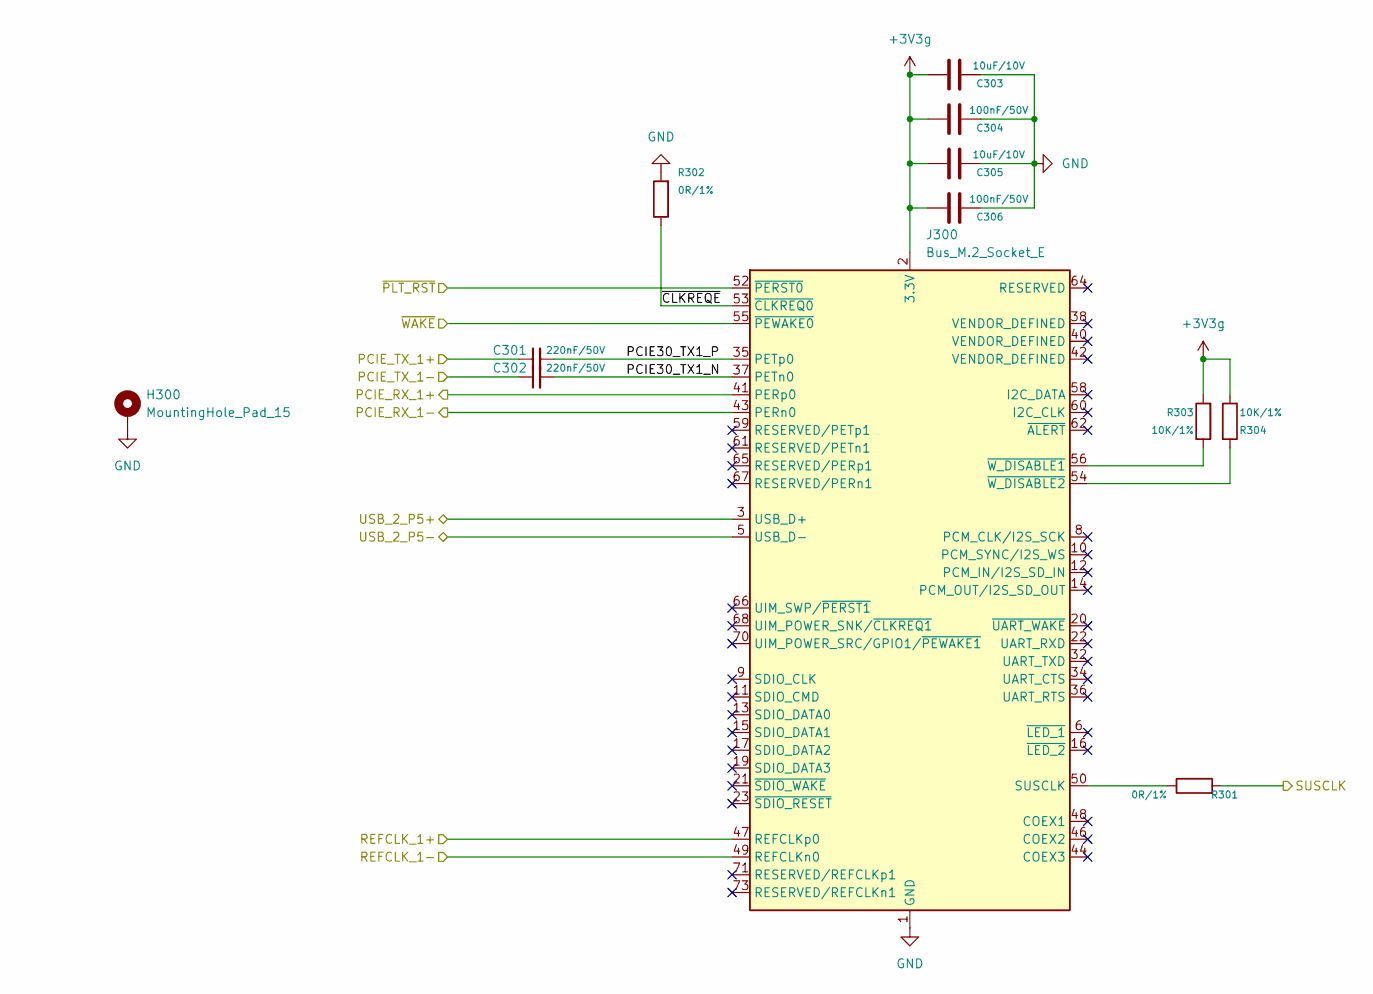
[picture p25: schematic M.2 E&M-Key.kicad_sch, part in row 1, column 2]

Parts:
C201, C202, C301, C302: 220nF/50V; C_0402_1005Metric; Part# C5159775; LCSC Part # C5159775
C203, C205, C303, C305: 10uF/10V; C_0402_1005Metric
C204, C206, C304, C306: 100nF/50V; C_0402_1005Metric
D201: LED_G; LED_0603_1608Metric
H242, H280, H300: MountingHole_Pad_15; MountingHole_3mm_M2_Pad_TopOnly; MPN SMTWEM215STR; LCSC Part # C5221852
J200: Bus_M.2_Socket_M; PCIe_M.2_Connectors_P=0.5mm_H=4.2mm_KeyM
J300: Bus_M.2_Socket_E; PCIe_M.2_Connectors_P=0.5mm_H=4.2mm_KeyE
R201: 2.2K/1%; R_0402_1005Metric
R202, R301, R302: 0R/1%; R_0402_1005Metric
R303, R304: 10K/1%; R_0402_1005Metric

Connections:
+3V3g: C203.2, C204.2, C205.2, C206.2, C303.2, C304.2, C305.2, C306.2, J200.2 (3.3V), J200.4 (3.3V), J200.12 (3.3V), J200.14 (3.3V), J200.16 (3.3V), J200.18 (3.3V), J200.70 (3.3V), J200.72 (3.3V), J200.74 (3.3V), J300.2 (3.3V), J300.4 (3.3V), J300.72 (3.3V), J300.74 (3.3V), R201.2, R303.2, R304.1
GND: C203.1, C204.1, C205.1, C206.1, C303.1, C304.1, C305.1, C306.1, H242.1, H280.1, H300.1, J200.1 (GND), J200.3 (GND), J200.9 (GND), J200.15 (GND), J200.21 (GND), J200.27 (GND), J200.33 (GND), J200.39 (GND), J200.45 (GND), J200.51 (GND), J200.57 (GND), J200.71 (GND), J200.73 (GND), J200.75 (GND), J200.MP1, J200.MP2, J300.1 (GND), J300.7 (GND), J300.18 (GND), J300.33 (GND), J300.39 (GND), J300.45 (GND), J300.51 (GND), J300.57 (GND), J300.63 (GND), J300.69 (GND), J300.75 (GND), J300.MP1, J300.MP2, R202.2, R302.2
unnamed: D201.1 (K), J200.10 (DAS/~DSS/~LED1)
unnamed: D201.2 (A), R201.1
unnamed: J300.50 (SUSCLK), R301.1
unnamed: J300.54 (~W_DISABLE2), R304.2
unnamed: J300.56 (~W_DISABLE1), R303.1
PCIE30_TX0_N: C202.2, J200.47 (PETn0/SATA-A-)
PCIE30_TX0_P: C201.2, J200.49 (PETp0/SATA-A+)
PCIE30_TX1_N: C302.2, J300.37 (PETn0)
PCIE30_TX1_P: C301.2, J300.35 (PETp0)
PCIE_RX_0+: J200.43 (PERp0/SATA-B-)
PCIE_RX_0-: J200.41 (PERn0/SATA-B+)
PCIE_RX_1+: J300.41 (PERp0)
PCIE_RX_1-: J300.43 (PERn0)
PCIE_TX_0+: C201.1
PCIE_TX_0-: C202.1
PCIE_TX_1+: C301.1
PCIE_TX_1-: C302.1
REFCLK_0+: J200.55 (REFCLKp)
REFCLK_0-: J200.53 (REFCLKn)
REFCLK_1+: J300.47 (REFCLKp0)
REFCLK_1-: J300.49 (REFCLKn0)
SUSCLK: R301.2
USB_2_P5+: J300.3 (USB_D+)
USB_2_P5-: J300.5 (USB_D-)
~CLKREQE: J300.53 (~CLKREQ0), R302.1
~CLKREQM: J200.52 (~CLKREQ), R202.1
~PLT_RST: J200.50 (~PERST), J300.52 (~PERST0)
~WAKE: J200.54 (~PEWAKE), J300.55 (~PEWAKE0)

Notes on the sheet:
SSD active LED
