El-Luhb/nvme-Carrier-for-LattePanda-Mu/PCB/4 Layer nvme Carrier all M2/PCIe CLK Buffer.kicad_sch

## KiCad design PCB/4 Layer nvme Carrier all M2/PCIe CLK Buffer.kicad_sch (2025-02-06)

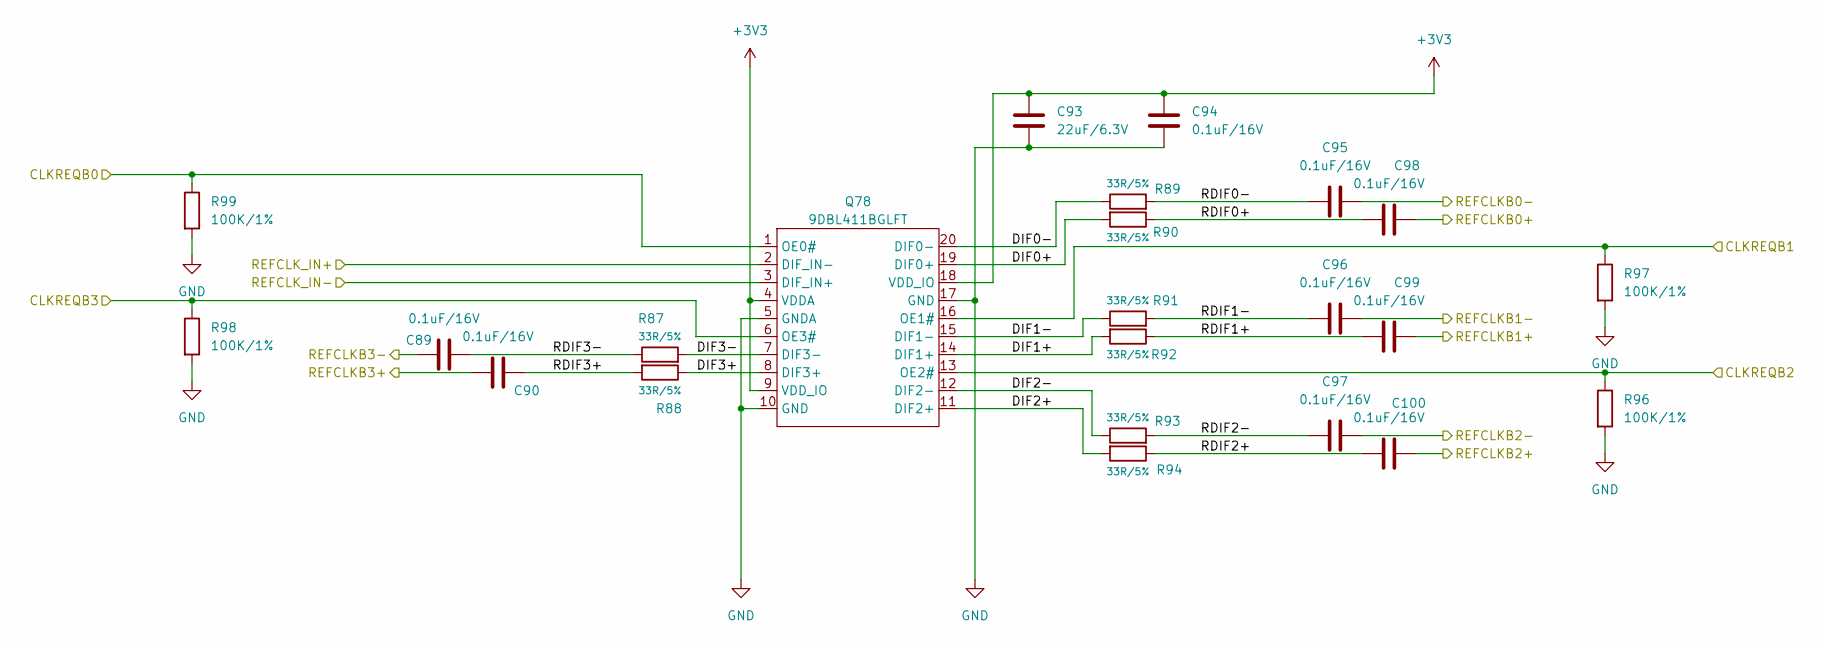
[picture p28: schematic PCIe CLK Buffer.kicad_sch]

Parts:
C89, C90, C94, C95, C96, C97, C98, C99, C100: 0.1uF/16V; C_0402_1005Metric; Part# C83056; LCSC Part # C83056
C93: 22uF/6.3V; C_0402_1005Metric; Part# C105226; LCSC Part # C105226
Q78: 9DBL411BGLFT; TSSOP-20_4.4x6.5mm_P0.65mm; MPN 9DBL411BGLFT; LCSC Part # C2649348
R87, R88, R89, R90, R91, R92, R93, R94: 33R/5%; R_0402_1005Metric; Part# C851857; LCSC Part # C851857
R96, R97, R98, R99: 100K/1%; R_0402_1005Metric; Part# C60491; LCSC Part # C60491

Connections:
+3V3: C93.1, C94.1, Q78.4 (VDDA), Q78.9 (VDD_IO), Q78.18 (VDD_IO)
CLKREQB0: Q78.1 (OE0#), R99.1
CLKREQB1: Q78.16 (OE1#), R97.1
CLKREQB2: Q78.13 (OE2#), R96.1
CLKREQB3: Q78.6 (OE3#), R98.1
DIF0+: Q78.19 (DIF0+), R90.2
DIF0-: Q78.20 (DIF0-), R89.1
DIF1+: Q78.14 (DIF1+), R92.2
DIF1-: Q78.15 (DIF1-), R91.1
DIF2+: Q78.11 (DIF2+), R94.2
DIF2-: Q78.12 (DIF2-), R93.1
DIF3+: Q78.8 (DIF3+), R88.1
DIF3-: Q78.7 (DIF3-), R87.2
GND: C93.2, C94.2, Q78.5 (GNDA), Q78.10 (GND), Q78.17 (GND), R96.2, R97.2, R98.2, R99.2
RDIF0+: C98.1, R90.1
RDIF0-: C95.1, R89.2
RDIF1+: C99.1, R92.1
RDIF1-: C96.1, R91.2
RDIF2+: C100.1, R94.1
RDIF2-: C97.1, R93.2
RDIF3+: C90.2, R88.2
RDIF3-: C89.2, R87.1
REFCLKB0+: C98.2
REFCLKB0-: C95.2
REFCLKB1+: C99.2
REFCLKB1-: C96.2
REFCLKB2+: C100.2
REFCLKB2-: C97.2
REFCLKB3+: C90.1
REFCLKB3-: C89.1
REFCLK_IN+: Q78.2 (DIF_IN-)
REFCLK_IN-: Q78.3 (DIF_IN+)
