El-Luhb/nvme-Carrier-for-LattePanda-Mu/PCB/4 Layer nvme Carrier all M2/PSU.kicad_sch

## KiCad design PCB/4 Layer nvme Carrier all M2/PSU.kicad_sch (2025-02-06)

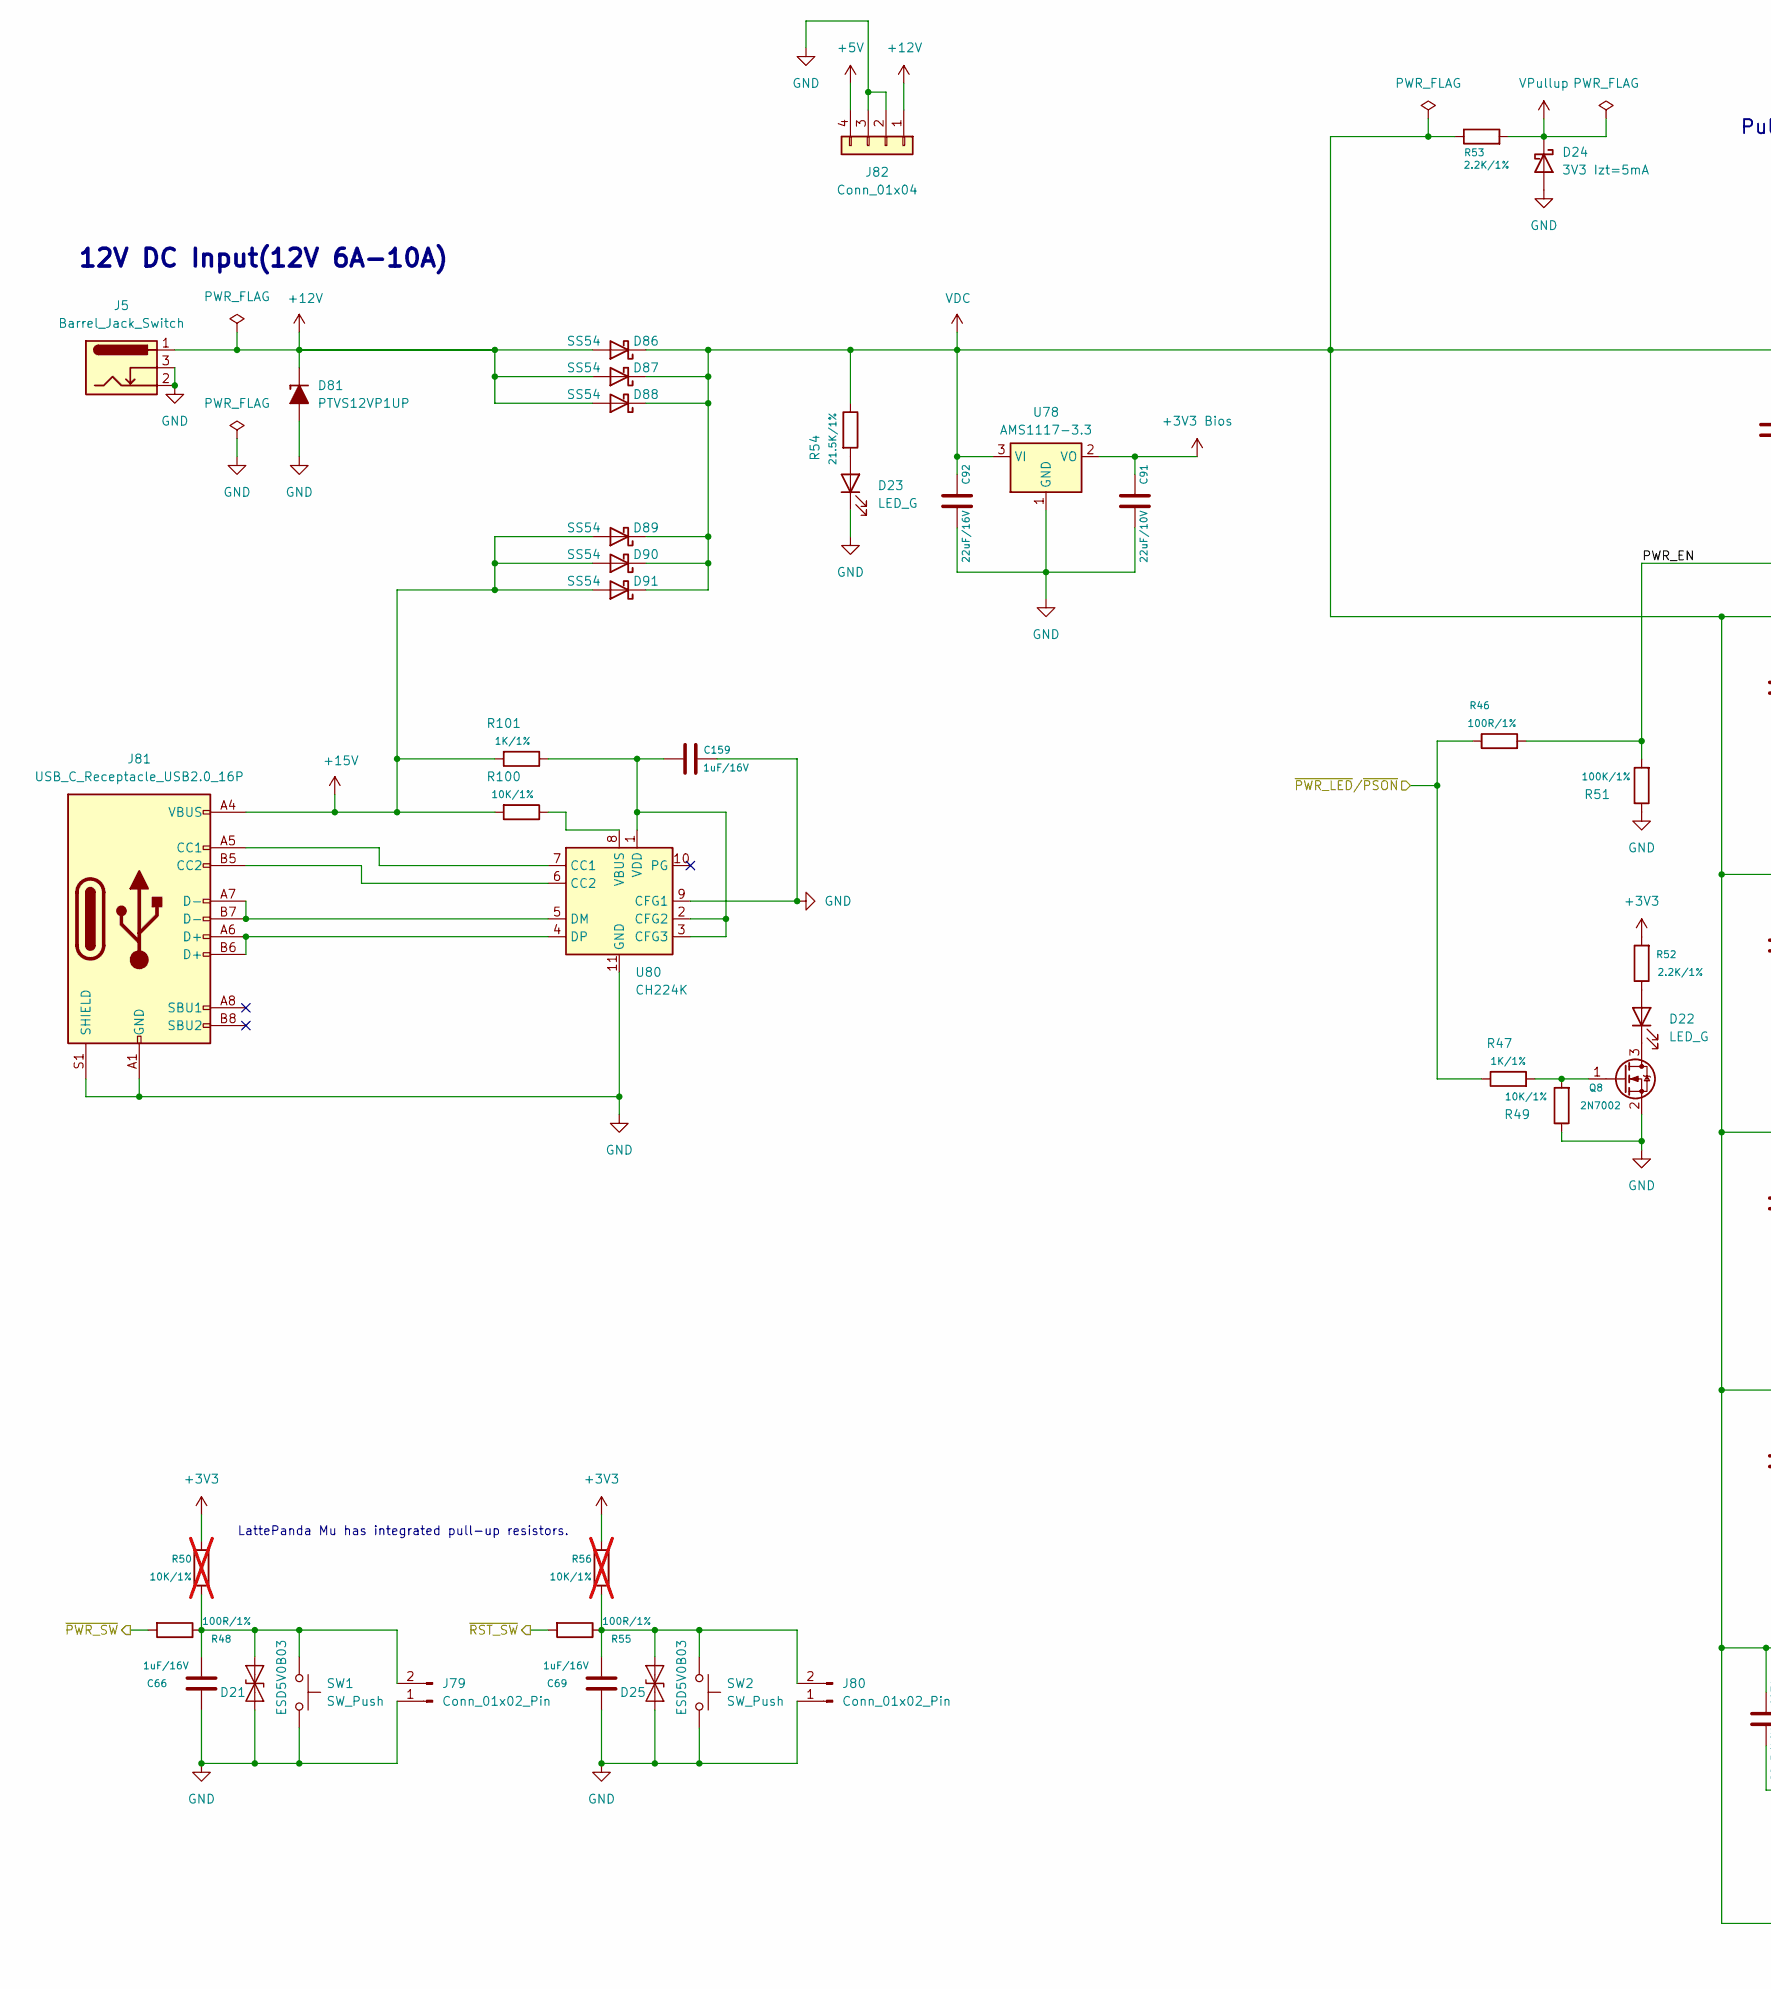
[picture p29: schematic PSU.kicad_sch, part in row 1, column 1]

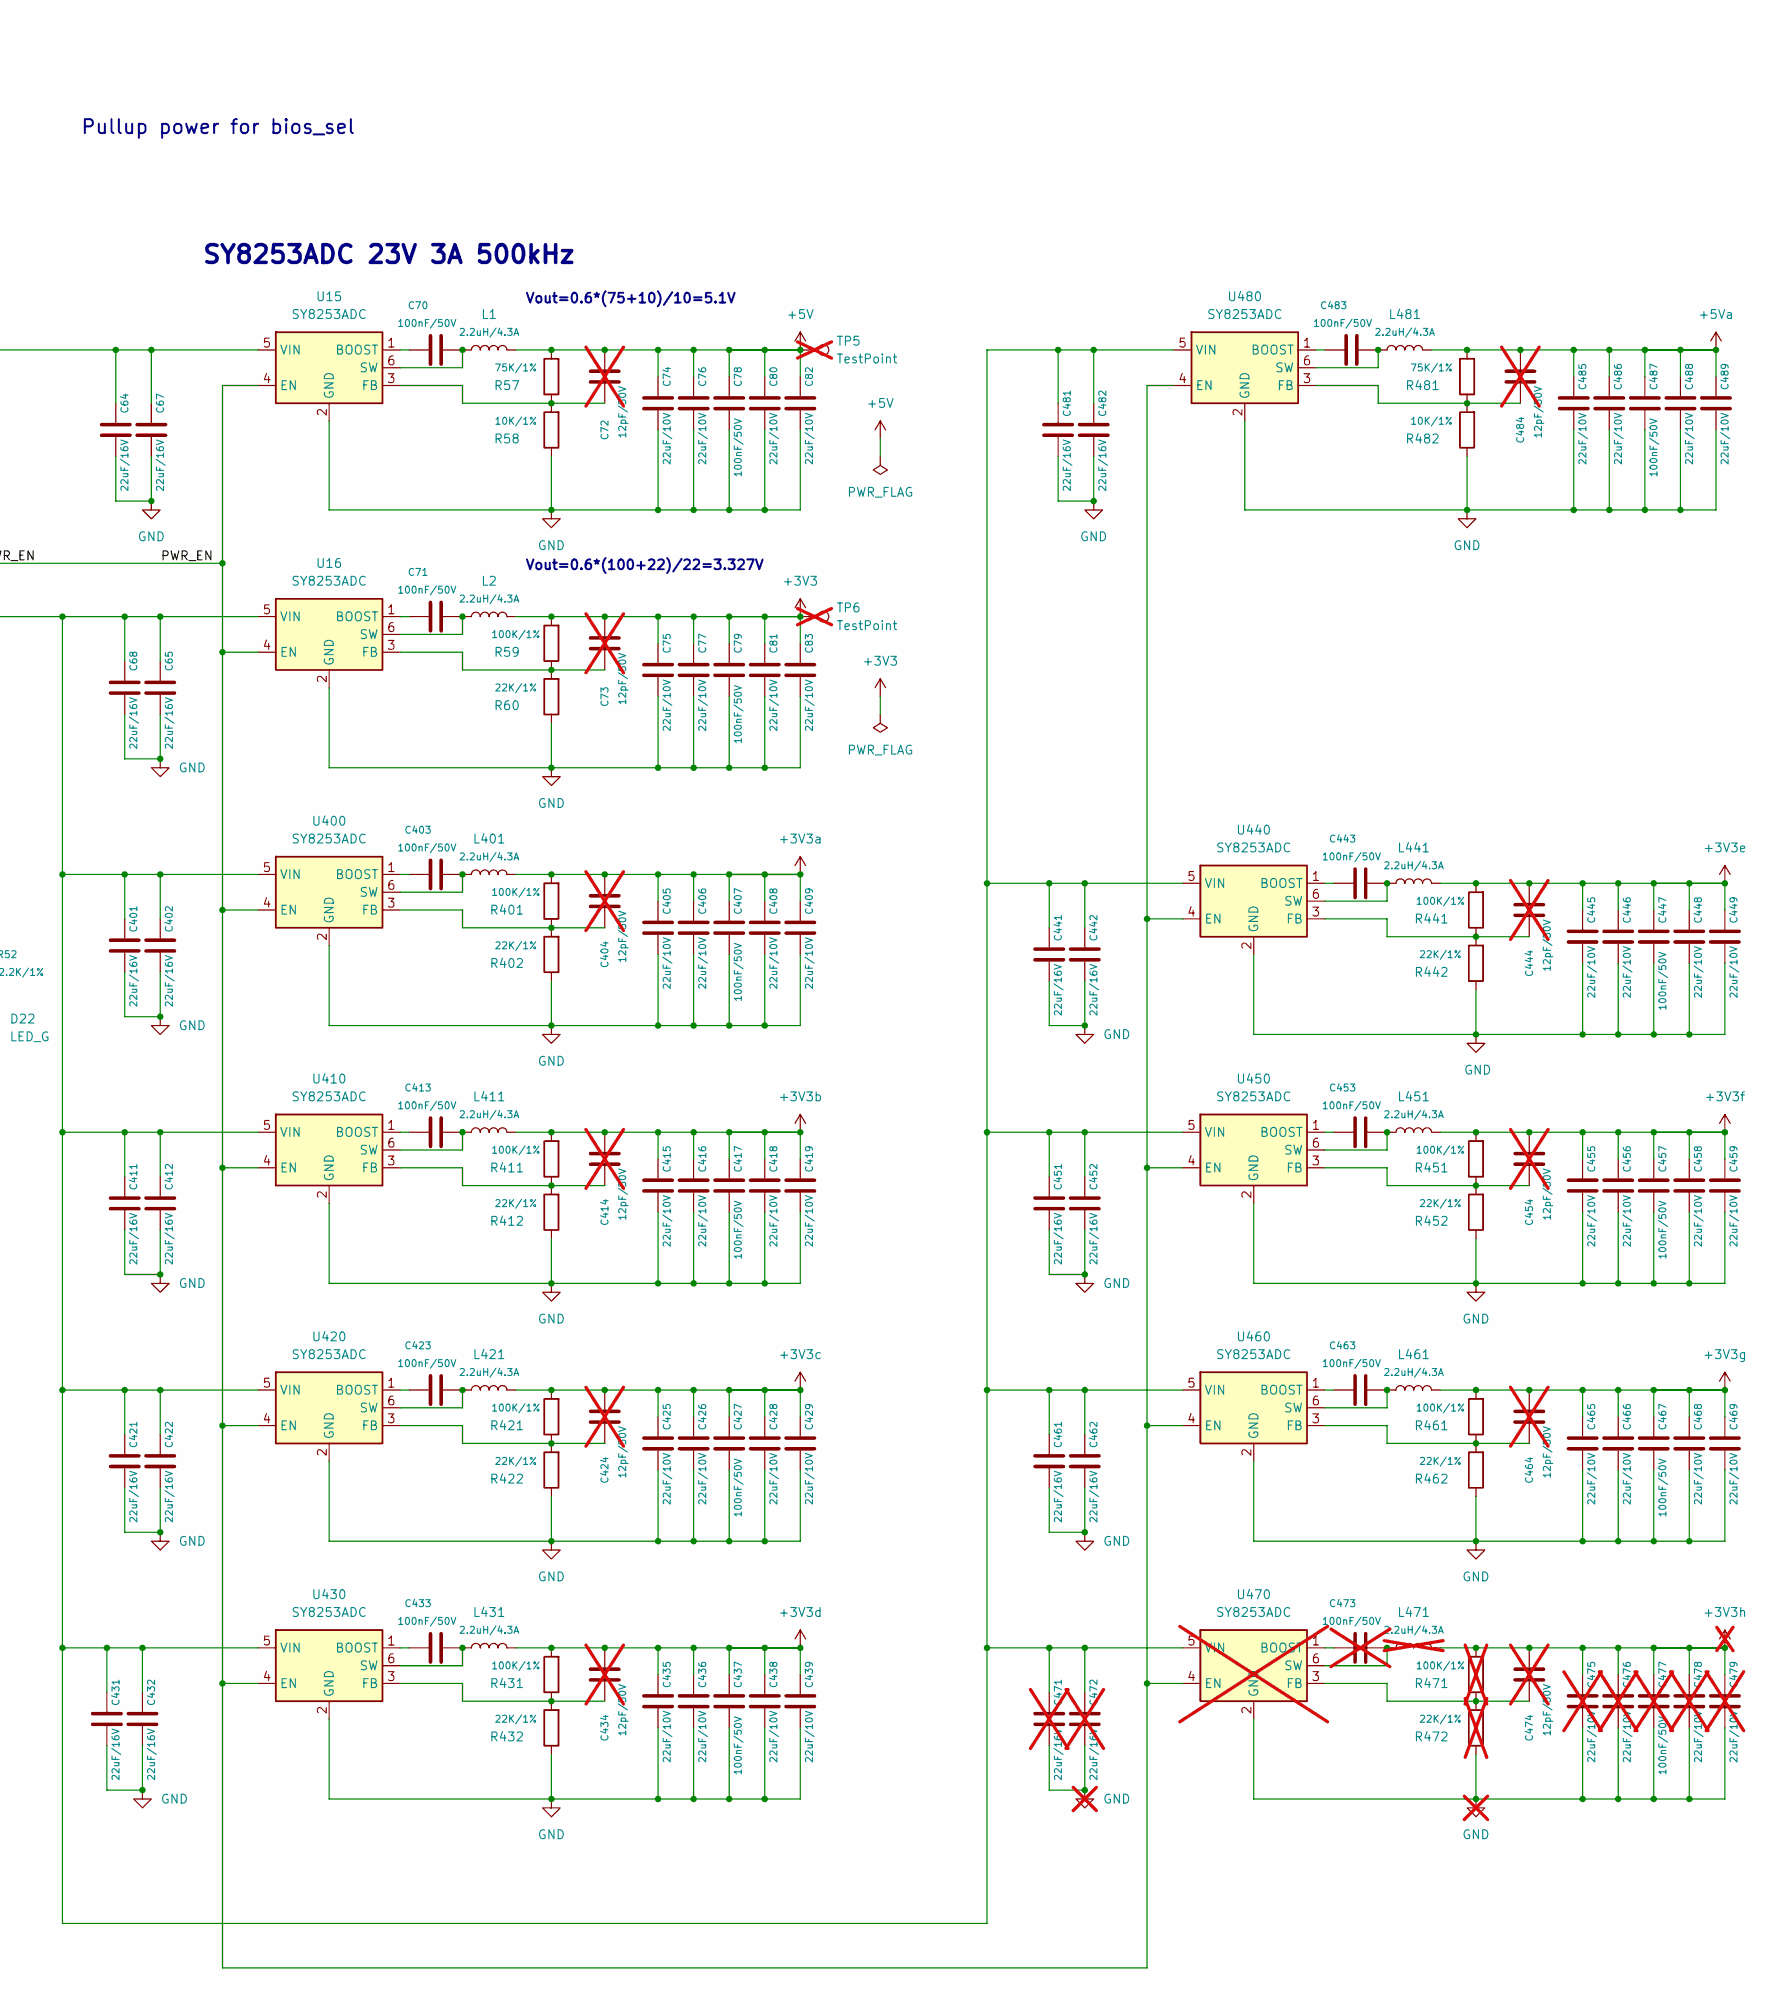
[picture p30: schematic PSU.kicad_sch, part in row 1, column 2]

Parts:
C64, C65, C67, C68, C92, C401, C402, C411, C412, C421, C422, C431, C432, C441, C442, C451, C452, C461, C462, C481, C482: 22uF/16V; C_0603_1608Metric; Part# C86295; LCSC Part # C2762594
C66, C69: 1uF/16V; C_0402_1005Metric; Part# C29266; LCSC Part # C29266
C70, C71, C78, C79, C403, C407, C413, C417, C423, C427, C433, C437, C443, C447, C453, C457, C463, C467, C483, C487: 100nF/50V; C_0402_1005Metric; Part# C77020; LCSC Part # C77020
C72, C73, C404, C414, C424, C434, C444, C454, C464, C474, C484: 12pF/50V; C_0402_1005Metric; not fitted
C74, C75, C76, C77, C80, C81, C82, C83, C91, C405, C406, C408, C409, C415, C416, C418, C419, C425, C426, C428, C429, C435, C436, C438, C439, C445, C446, C448, C449, C455, C456, C458, C459, C465, C466, C468, C469, C485, C486, C488, C489: 22uF/10V; C_0603_1608Metric; Part# C86295; LCSC Part # C86295
C159: 1uF/16V; C_0402_1005Metric
C471, C472: 22uF/16V; C_0603_1608Metric; Part# C86295; LCSC Part # C86295; not fitted
C473, C477: 100nF/50V; C_0402_1005Metric; Part# C77020; LCSC Part # C77020; not fitted
C475, C476, C478, C479: 22uF/10V; C_0603_1608Metric; Part# C86295; LCSC Part # C86295; not fitted
D21, D25: ESD5V0B03; D_0402_1005Metric; Part# C521894; LCSC Part # C521894
D22, D23: LED_G; LED_0603_1608Metric; Part# C434423; LCSC Part # C434423
D24: 3V3 Izt=5mA; D_SOD-323; Part# C5674189; LCSC Part # C894530
D81: PTVS12VP1UP; D_SOD-128; MPN PTVS12VP1UP,115; LCSC Part # C553365
D86, D87, D88, D89, D90, D91: SS54; D_SMA
J5: Barrel_Jack_Switch; DC_Jack_DC007B_30V_10A; Part# C17701686; LCSC Part # C19189084
J79, J80: Conn_01x02_Pin; PinHeader_1x02_P2.54mm_Vertical; MPN PZ2.54-1*2
J81: USB_C_Receptacle_USB2.0_16P; USB_C_Receptacle_G-Switch_GT-USB-7010ASV; MPN GT-USB-7010ASV; LCSC Part # C2988369
J82: Conn_01x04; TE_MATE-N-LOK_350211-1_1x04_P5.08mm_Vertical; Part# C305819; LCSC Part # C305819
L1, L2, L401, L411, L421, L431, L441, L451, L461, L481: 2.2uH/4.3A; L_Sunlord_SWPA4020S; Part# C98361; LCSC Part # C98361
L471: 2.2uH/4.3A; L_Sunlord_SWPA4020S; Part# C98361; LCSC Part # C98361; not fitted
Q8: 2N7002; SOT-23; Part# C7603342; LCSC Part # C7603342
R46, R48, R55: 100R/1%; R_0402_1005Metric; Part# C106232; LCSC Part # C106232
R47: 1K/1%; R_0402_1005Metric; Part# C106235; LCSC Part # C106235
R49, R58, R482: 10K/1%; R_0402_1005Metric; Part# C60490; LCSC Part # C60490
R50, R56: 10K/1%; R_0402_1005Metric; Part# C60490; LCSC Part # C60490; not fitted
R51, R59, R401, R411, R421, R431, R441, R451, R461: 100K/1%; R_0402_1005Metric; Part# C60491; LCSC Part # C60491
R52, R53: 2.2K/1%; R_0402_1005Metric; Part# C114762; LCSC Part # C114762
R54: 21.5K/1%; R_0402_1005Metric; Part# C185442; LCSC Part # C185442
R57, R481: 75K/1%; R_0402_1005Metric; Part# C137935; LCSC Part # C137935
R60, R402, R412, R422, R432, R442, R452, R462: 22K/1%; R_0402_1005Metric; Part# C82868; LCSC Part # C82868
R100: 10K/1%; R_0402_1005Metric; Part# C185442; LCSC Part # C185442
R101: 1K/1%; R_0402_1005Metric; Part# C185442; LCSC Part # C185442
R471: 100K/1%; R_0402_1005Metric; Part# C60491; LCSC Part # C60491; not fitted
R472: 22K/1%; R_0402_1005Metric; Part# C82868; LCSC Part # C82868; not fitted
SW1, SW2: SW_Push; SW_Push_6x6x6; Part# C2685894; LCSC Part # C224978
TP5, TP6: TestPoint; TestPoint_Pad_D1.5mm; not fitted
U15, U16, U400, U410, U420, U430, U440, U450, U460, U480: SY8253ADC; TSOT-23-6; Part# C93736; LCSC Part # C93736
U78: AMS1117-3.3; SOT-223-3_TabPin2; MPN AMS1117-3.3; LCSC Part # C347222
U80: CH224K; SSOP-10-1EP_3.9x4.9mm_P1mm_EP2.1x3.3mm
U470: SY8253ADC; TSOT-23-6; Part# C93736; LCSC Part # C93736; not fitted

Connections:
+3V3: C73.1, C75.2, C77.2, C79.1, C81.2, C83.2, L2.2, R50.2, R52.2, R56.2, R59.2, TP6.1
+3V3 Bios: C91.2, U78.2 (VO)
+3V3a: C404.1, C405.2, C406.2, C407.1, C408.2, C409.2, L401.2, R401.2
+3V3b: C414.1, C415.2, C416.2, C417.1, C418.2, C419.2, L411.2, R411.2
+3V3c: C424.1, C425.2, C426.2, C427.1, C428.2, C429.2, L421.2, R421.2
+3V3d: C434.1, C435.2, C436.2, C437.1, C438.2, C439.2, L431.2, R431.2
+3V3e: C444.1, C445.2, C446.2, C447.1, C448.2, C449.2, L441.2, R441.2
+3V3f: C454.1, C455.2, C456.2, C457.1, C458.2, C459.2, L451.2, R451.2
+3V3g: C464.1, C465.2, C466.2, C467.1, C468.2, C469.2, L461.2, R461.2
+3V3h: C474.1, C475.2, C476.2, C477.1, C478.2, C479.2, L471.2, R471.2
+5V: C72.1, C74.2, C76.2, C78.1, C80.2, C82.2, J82.4, L1.2, R57.2, TP5.1
+5Va: C484.1, C485.2, C486.2, C487.1, C488.2, C489.2, L481.2, R481.2
+12V: D81.1 (K), D86.2 (A), D87.2 (A), D88.2 (A), J5.1, J82.1
+15V: D89.2 (A), D90.2 (A), D91.2 (A), J81.A4 (VBUS), J81.A9 (VBUS), J81.B4 (VBUS), J81.B9 (VBUS), R100.2, R101.2
GND: C64.1, C65.1, C66.2, C67.1, C68.1, C69.2, C74.1, C75.1, C76.1, C77.1, C78.2, C79.2, C80.1, C81.1, C82.1, C83.1, C91.1, C92.1, C159.1, C401.1, C402.1, C405.1, C406.1, C407.2, C408.1, C409.1, C411.1, C412.1, C415.1, C416.1, C417.2, C418.1, C419.1, C421.1, C422.1, C425.1, C426.1, C427.2, C428.1, C429.1, C431.1, C432.1, C435.1, C436.1, C437.2, C438.1, C439.1, C441.1, C442.1, C445.1, C446.1, C447.2, C448.1, C449.1, C451.1, C452.1, C455.1, C456.1, C457.2, C458.1, C459.1, C461.1, C462.1, C465.1, C466.1, C467.2, C468.1, C469.1, C471.1, C472.1, C475.1, C476.1, C477.2, C478.1, C479.1, C481.1, C482.1, C485.1, C486.1, C487.2, C488.1, C489.1, D21.1 (A1), D23.1 (K), D24.2 (A), D25.1 (A1), D81.2 (A), J5.2, J5.3, J79.1, J80.1, J81.A1 (GND), J81.A12 (GND), J81.B1 (GND), J81.B12 (GND), J81.S1 (SHIELD), J82.2, J82.3, Q8.2 (S), R49.1, R51.1, R58.1, R60.1, R402.1, R412.1, R422.1, R432.1, R442.1, R452.1, R462.1, R472.1, R482.1, SW1.2, SW2.2, U15.2 (GND), U16.2 (GND), U78.1 (GND), U80.9 (CFG1), U80.11 (GND), U400.2 (GND), U410.2 (GND), U420.2 (GND), U430.2 (GND), U440.2 (GND), U450.2 (GND), U460.2 (GND), U470.2 (GND), U480.2 (GND)
unnamed: C66.1, D21.2 (A2), J79.2, R48.1, R50.1, SW1.1
unnamed: C69.1, D25.2 (A2), J80.2, R55.1, R56.1, SW2.1
unnamed: C70.1, L1.1, U15.6 (SW)
unnamed: C70.2, U15.1 (BOOST)
unnamed: C71.1, L2.1, U16.6 (SW)
unnamed: C71.2, U16.1 (BOOST)
unnamed: C72.2, R57.1, R58.2, U15.3 (FB)
unnamed: C73.2, R59.1, R60.2, U16.3 (FB)
unnamed: C159.2, R101.1, U80.1 (VDD), U80.2 (CFG2), U80.3 (CFG3)
unnamed: C403.1, L401.1, U400.6 (SW)
unnamed: C403.2, U400.1 (BOOST)
unnamed: C404.2, R401.1, R402.2, U400.3 (FB)
unnamed: C413.1, L411.1, U410.6 (SW)
unnamed: C413.2, U410.1 (BOOST)
unnamed: C414.2, R411.1, R412.2, U410.3 (FB)
unnamed: C423.1, L421.1, U420.6 (SW)
unnamed: C423.2, U420.1 (BOOST)
unnamed: C424.2, R421.1, R422.2, U420.3 (FB)
unnamed: C433.1, L431.1, U430.6 (SW)
unnamed: C433.2, U430.1 (BOOST)
unnamed: C434.2, R431.1, R432.2, U430.3 (FB)
unnamed: C443.1, L441.1, U440.6 (SW)
unnamed: C443.2, U440.1 (BOOST)
unnamed: C444.2, R441.1, R442.2, U440.3 (FB)
unnamed: C453.1, L451.1, U450.6 (SW)
unnamed: C453.2, U450.1 (BOOST)
unnamed: C454.2, R451.1, R452.2, U450.3 (FB)
unnamed: C463.1, L461.1, U460.6 (SW)
unnamed: C463.2, U460.1 (BOOST)
unnamed: C464.2, R461.1, R462.2, U460.3 (FB)
unnamed: C473.1, L471.1, U470.6 (SW)
unnamed: C473.2, U470.1 (BOOST)
unnamed: C474.2, R471.1, R472.2, U470.3 (FB)
unnamed: C483.1, L481.1, U480.6 (SW)
unnamed: C483.2, U480.1 (BOOST)
unnamed: C484.2, R481.1, R482.2, U480.3 (FB)
unnamed: D22.1 (K), Q8.3 (D)
unnamed: D22.2 (A), R52.1
unnamed: D23.2 (A), R54.2
unnamed: J81.A5 (CC1), U80.7 (CC1)
unnamed: J81.A6 (D+), J81.B6 (D+), U80.4 (DP)
unnamed: J81.A7 (D-), J81.B7 (D-), U80.5 (DM)
unnamed: J81.B5 (CC2), U80.6 (CC2)
unnamed: Q8.1 (G), R47.2, R49.2
unnamed: R100.1, U80.8 (VBUS)
PWR_EN: R46.2, R51.2, U15.4 (EN), U16.4 (EN), U400.4 (EN), U410.4 (EN), U420.4 (EN), U430.4 (EN), U440.4 (EN), U450.4 (EN), U460.4 (EN), U470.4 (EN), U480.4 (EN)
VDC: C64.2, C65.2, C67.2, C68.2, C92.2, C401.2, C402.2, C411.2, C412.2, C421.2, C422.2, C431.2, C432.2, C441.2, C442.2, C451.2, C452.2, C461.2, C462.2, C471.2, C472.2, C481.2, C482.2, D86.1 (K), D87.1 (K), D88.1 (K), D89.1 (K), D90.1 (K), D91.1 (K), R53.1, R54.1, U15.5 (VIN), U16.5 (VIN), U78.3 (VI), U400.5 (VIN), U410.5 (VIN), U420.5 (VIN), U430.5 (VIN), U440.5 (VIN), U450.5 (VIN), U460.5 (VIN), U470.5 (VIN), U480.5 (VIN)
VPullup: D24.1 (K), R53.2
~PWR_LED/~PSON: R46.1, R47.1
~PWR_SW: R48.2
~RST_SW: R55.2

Notes on the sheet:
SY8253ADC 23V 3A 500kHz
LattePanda Mu has integrated pull-up resistors.
Vout=0.6*(75+10)/10=5.1V
12V DC Input(12V 6A-10A)
Pullup power for bios_sel
Vout=0.6*(100+22)/22=3.327V
