El-Luhb/nvme-Carrier-for-LattePanda-Mu/PCB/4 Layer nvme Carrier all M2/USB.kicad_sch

## KiCad design PCB/4 Layer nvme Carrier all M2/USB.kicad_sch (2025-02-06)

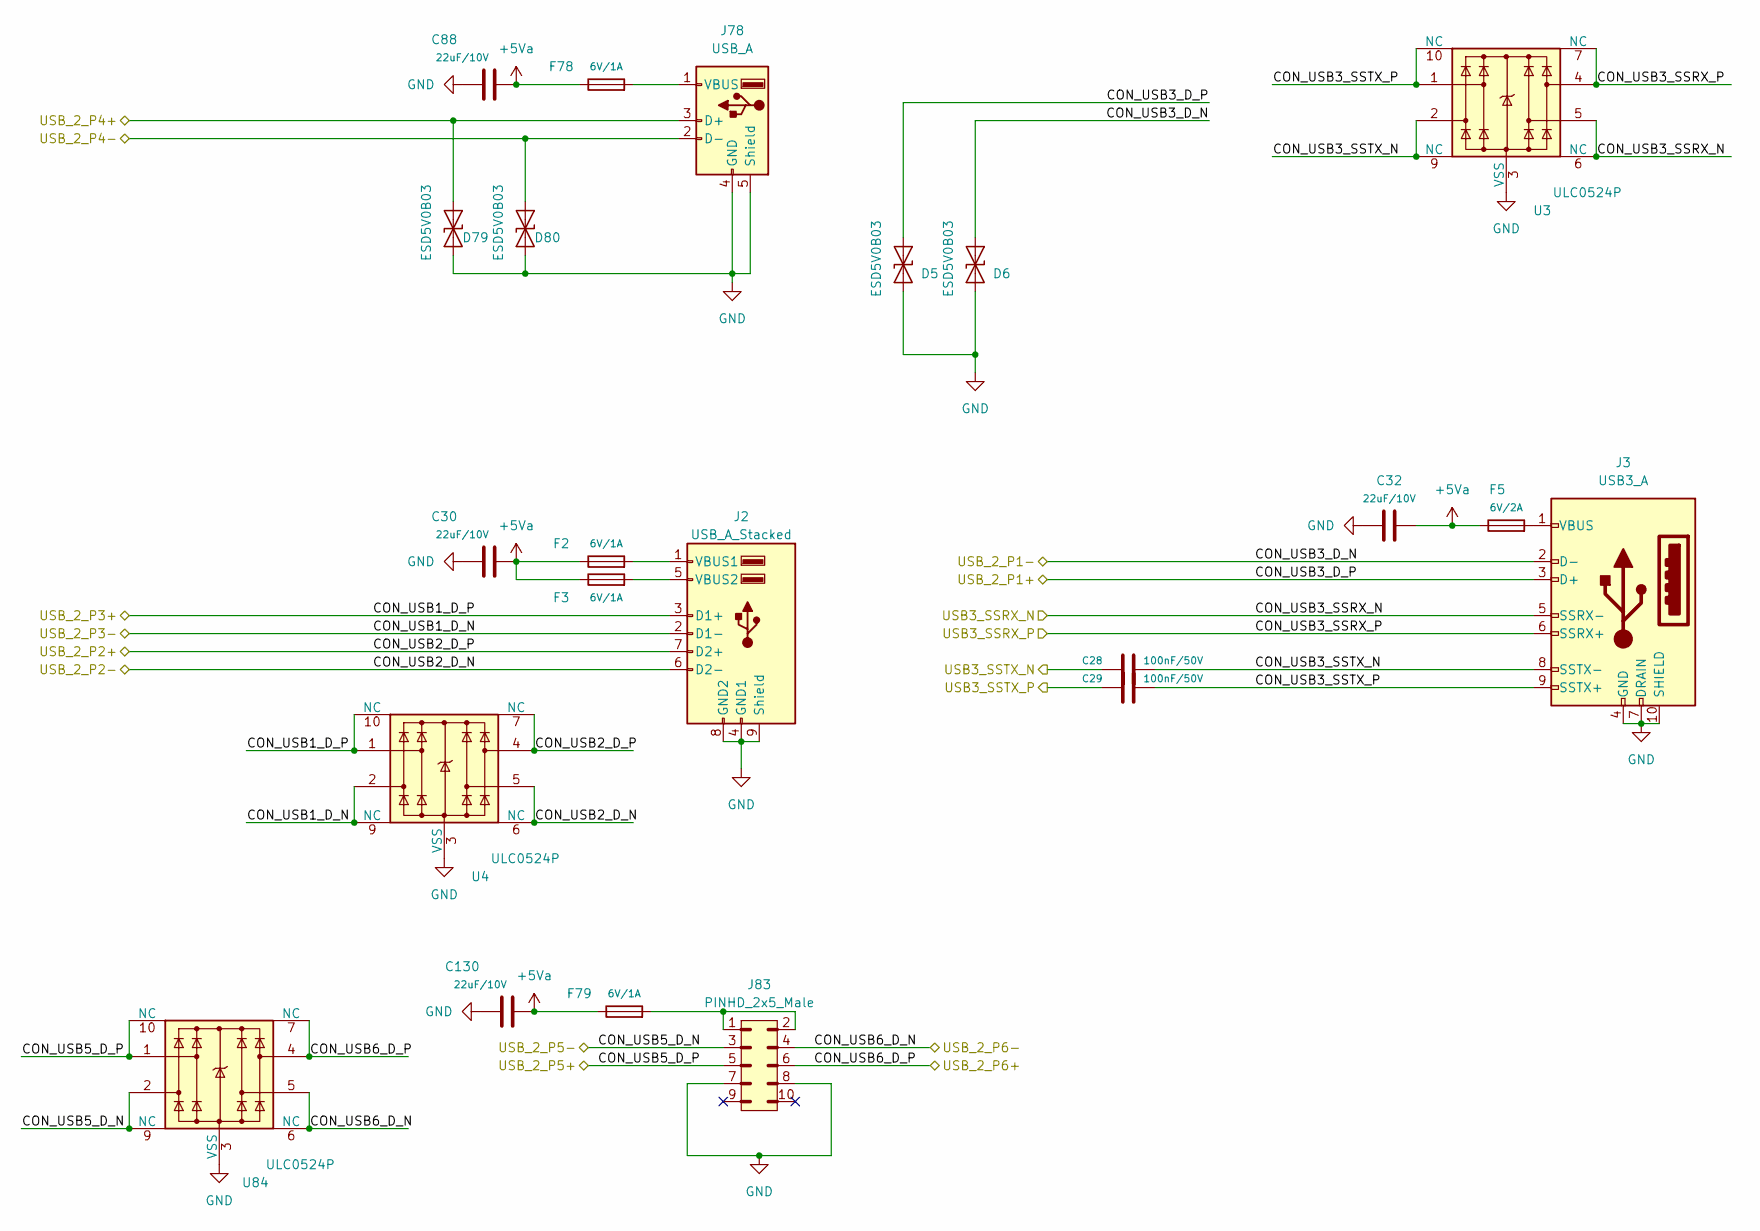
[picture p31: schematic USB.kicad_sch]

Parts:
C28, C29: 100nF/50V; C_0402_1005Metric; Part# C77020; LCSC Part # C77020
C30, C32, C88, C130: 22uF/10V; C_0603_1608Metric; Part# C86295; LCSC Part # C86295
D5, D6, D79, D80: ESD5V0B03; D_0402_1005Metric; Part# C521894; LCSC Part # C521894
F2, F3, F78, F79: 6V/1A; Fuse_0805_2012Metric; Part# C883112; LCSC Part # C883112
F5: 6V/2A; Fuse_0805_2012Metric; Part# C2757931; LCSC Part # C2757931
J2: USB_A_Stacked; USB_A_CUI_UJ2-ADH-TH_Horizontal_Stacked; Part# C3197848; LCSC Part # C456021
J3: USB3_A; USB3_A_Receptacle_Wuerth_692122030100; MPN 692122030100
J78: USB_A; USB_A_Molex_105057_Vertical; Part# C586225; LCSC Part # C586225
J83: PINHD_2x5_Male; PinHeader_2x05_P2.54mm_Vertical; MPN PZ254V-12-10P; LCSC Part # C492422
U3, U4, U84: ULC0524P; Diodes_UDFN-10_1.0x2.5mm_P0.5mm; Part# C2835428; LCSC Part # C2835428

Connections:
+5Va: C30.2, C32.2, C88.2, C130.2, F2.1, F3.1, F5.1, F78.1, F79.1
CON_USB1_D_N: J2.2 (D1-), U4.2, U4.9 (NC)
CON_USB1_D_P: J2.3 (D1+), U4.1, U4.10 (NC)
CON_USB2_D_N: J2.6 (D2-), U4.5, U4.6 (NC)
CON_USB2_D_P: J2.7 (D2+), U4.4, U4.7 (NC)
CON_USB3_D_N: D6.2 (A2), J3.2 (D-)
CON_USB3_D_P: D5.2 (A2), J3.3 (D+)
CON_USB3_SSRX_N: J3.5 (SSRX-), U3.5, U3.6 (NC)
CON_USB3_SSRX_P: J3.6 (SSRX+), U3.4, U3.7 (NC)
CON_USB3_SSTX_N: C28.2, J3.8 (SSTX-), U3.2, U3.9 (NC)
CON_USB3_SSTX_P: C29.2, J3.9 (SSTX+), U3.1, U3.10 (NC)
CON_USB5_D_N: J83.3, U84.2, U84.9 (NC)
CON_USB5_D_P: J83.5, U84.1, U84.10 (NC)
CON_USB6_D_N: J83.4, U84.5, U84.6 (NC)
CON_USB6_D_P: J83.6, U84.4, U84.7 (NC)
GND: C30.1, C32.1, C88.1, C130.1, D5.1 (A1), D6.1 (A1), D79.1 (A1), D80.1 (A1), J2.4 (GND1), J2.8 (GND2), J2.9 (Shield), J3.4 (GND), J3.7 (DRAIN), J3.10 (SHIELD), J78.4 (GND), J78.5 (Shield), J83.7, J83.8, U3.3 (VSS), U3.8 (VSS), U4.3 (VSS), U4.8 (VSS), U84.3 (VSS), U84.8 (VSS)
unnamed: F2.2, J2.1 (VBUS1)
unnamed: F3.2, J2.5 (VBUS2)
unnamed: F5.2, J3.1 (VBUS)
unnamed: F78.2, J78.1 (VBUS)
unnamed: F79.2, J83.1, J83.2
USB3_SSTX_N: C28.1
USB3_SSTX_P: C29.1
USB_2_P4+: D79.2 (A2), J78.3 (D+)
USB_2_P4-: D80.2 (A2), J78.2 (D-)
