El-Luhb/nvme-Carrier-for-LattePanda-Mu/PCB/4 Layer nvme Carrier all M2/fan_temp.kicad_sch

## KiCad design PCB/4 Layer nvme Carrier all M2/fan_temp.kicad_sch (2025-02-06)

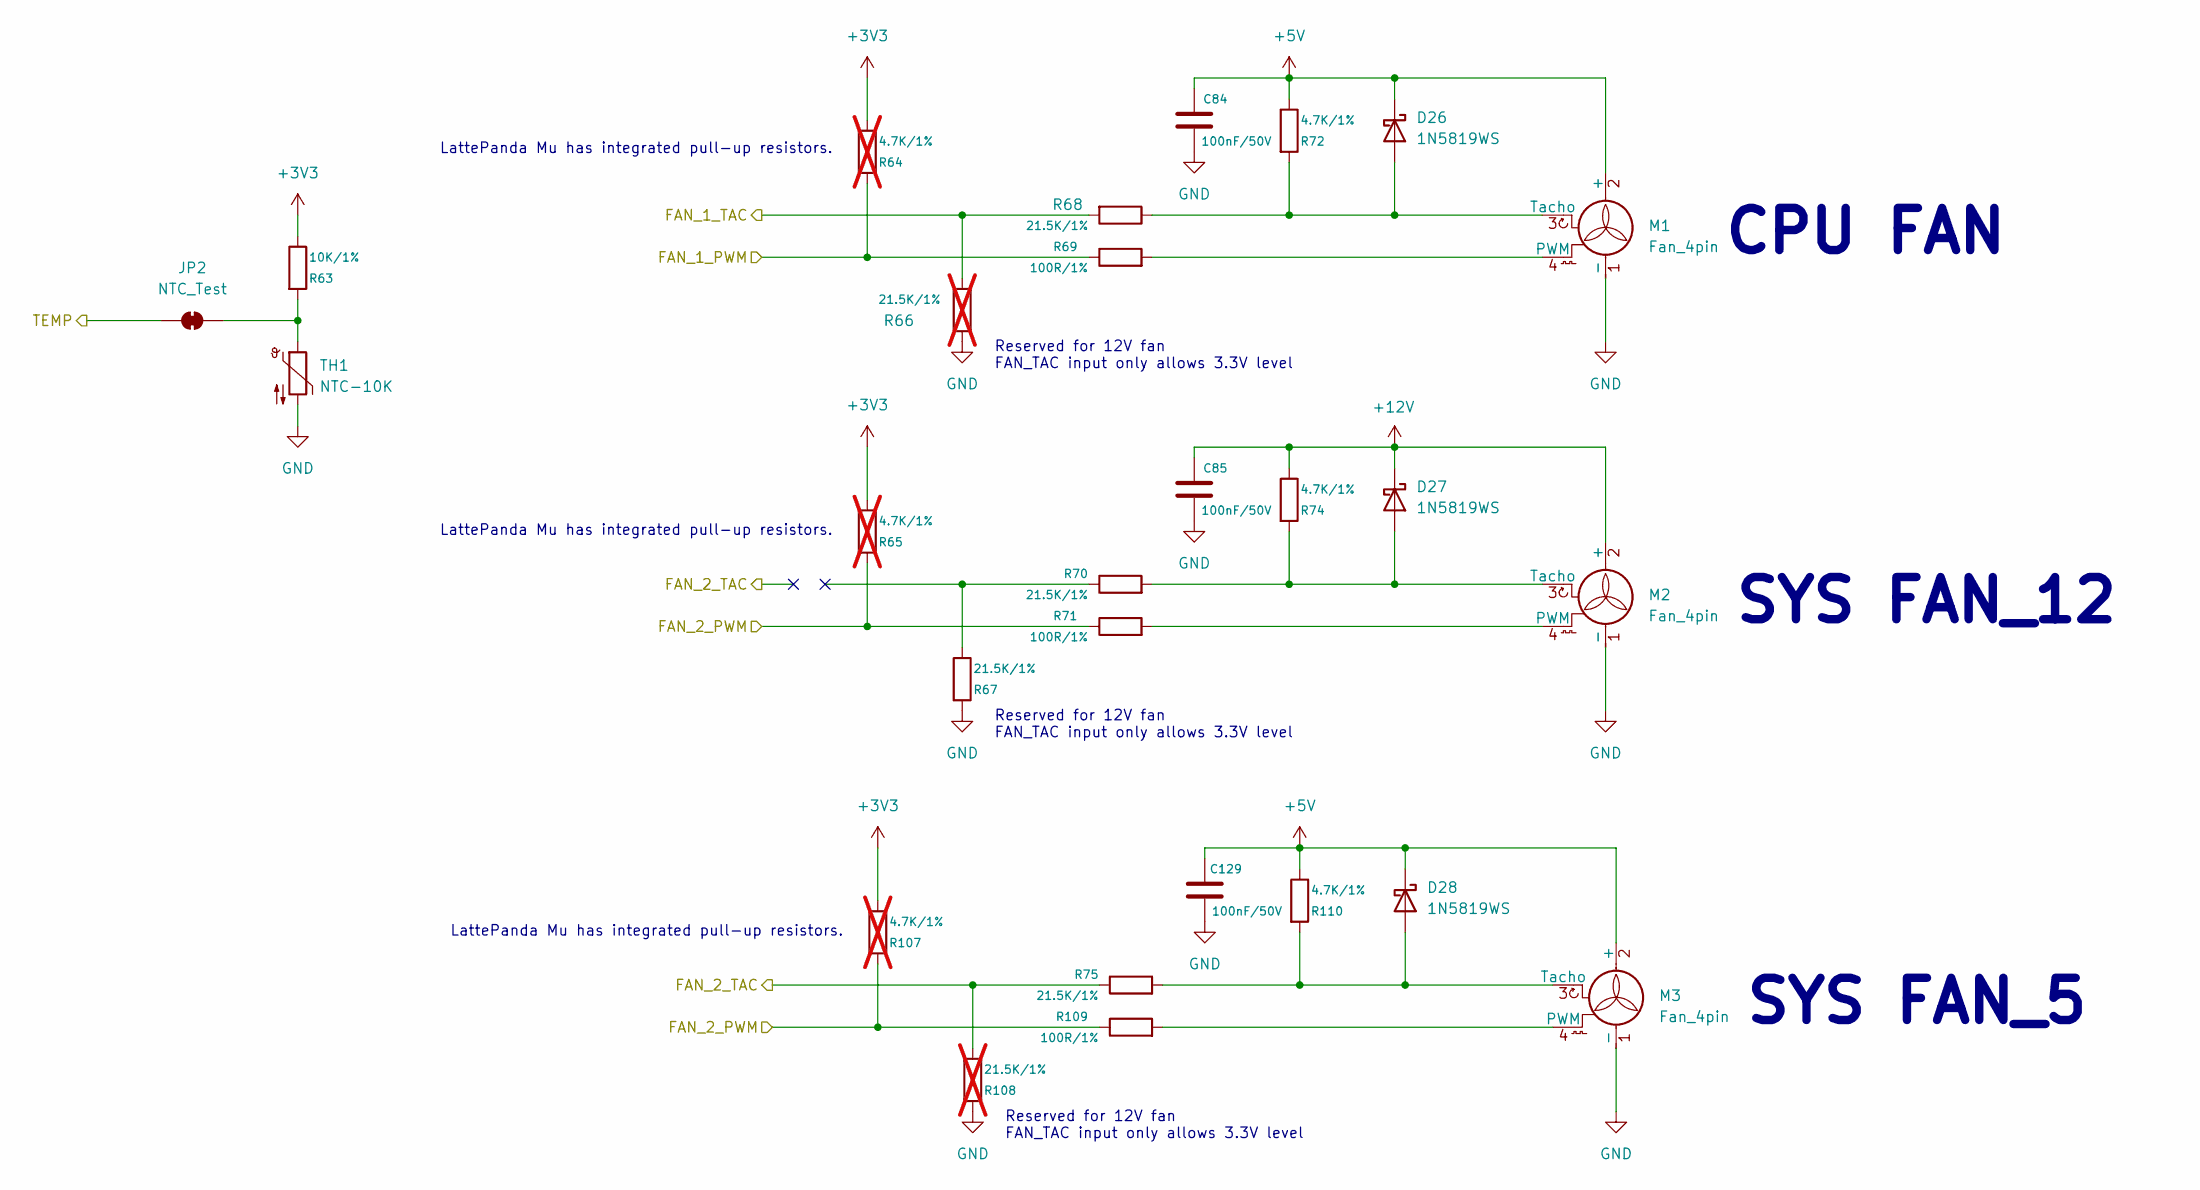
[picture p32: schematic fan_temp.kicad_sch]

Parts:
C84, C85, C129: 100nF/50V; C_0402_1005Metric; Part# C77020; LCSC Part # C77020
D26, D27, D28: 1N5819WS; D_SOD-323; Part# C2828425; LCSC Part # C2828425
JP2: NTC_Test; SolderJumper-2_P1.3mm_Bridged_RoundedPad1.0x1.5mm
M1: Fan_4pin; JST_PH_B4B-PH-K_1x04_P2.00mm_Vertical; Part# C566011; LCSC Part # C566011
M2, M3: Fan_4pin; FanPinHeader_1x04_P2.54mm_Vertical; Part# C240840; LCSC Part # C240840
R63: 10K/1%; R_0402_1005Metric; Part# C60490; LCSC Part # C60490
R64, R65, R107: 4.7K/1%; R_0402_1005Metric; Part# C105871; LCSC Part # C105871; not fitted
R66, R108: 21.5K/1%; R_0402_1005Metric; Part# C185442; LCSC Part # C185442; not fitted
R67, R68, R70, R75: 21.5K/1%; R_0402_1005Metric; Part# C185442; LCSC Part # C185442
R69, R71, R109: 100R/1%; R_0402_1005Metric; Part# C106232; LCSC Part # C106232
R72, R74, R110: 4.7K/1%; R_0402_1005Metric; Part# C105871; LCSC Part # C105871
TH1: NTC-10K; R_0603_1608Metric; Part# C440252; LCSC Part # C440252

Connections:
+3V3: R63.1, R64.1, R65.1, R107.1
+5V: C84.1, C129.1, D26.1 (K), D28.1 (K), M1.2 (+), M3.2 (+), R72.1, R110.1
+12V: C85.1, D27.1 (K), M2.2 (+), R74.1
FAN_1_PWM: R64.2, R69.1
FAN_1_TAC: R66.1, R68.2
FAN_2_PWM: R65.2, R71.1, R107.2, R109.1
FAN_2_TAC: R75.1, R108.1
GND: C84.2, C85.2, C129.2, M1.1 (-), M2.1 (-), M3.1 (-), R66.2, R67.2, R108.2, TH1.2
unnamed: D26.2 (A), M1.3 (Tacho), R68.1, R72.2
unnamed: D27.2 (A), M2.3 (Tacho), R70.2, R74.2
unnamed: D28.2 (A), M3.3 (Tacho), R75.2, R110.2
unnamed: JP2.2 (B), R63.2, TH1.1
unnamed: M1.4 (PWM), R69.2
unnamed: M2.4 (PWM), R71.2
unnamed: M3.4 (PWM), R109.2
unnamed: R67.1, R70.1
TEMP: JP2.1 (A)

Notes on the sheet:
CPU FAN
SYS FAN_5
SYS FAN_12
Reserved for 12V fan FAN_TAC input only allows 3.3V level
LattePanda Mu has integrated pull-up resistors.
