El-Luhb/nvme-Carrier-for-LattePanda-Mu/PCB/4 Layer nvme Carrier all M2/nvme Carrier all M2.kicad_sch

## KiCad design PCB/4 Layer nvme Carrier all M2/nvme Carrier all M2.kicad_sch (2025-02-06)

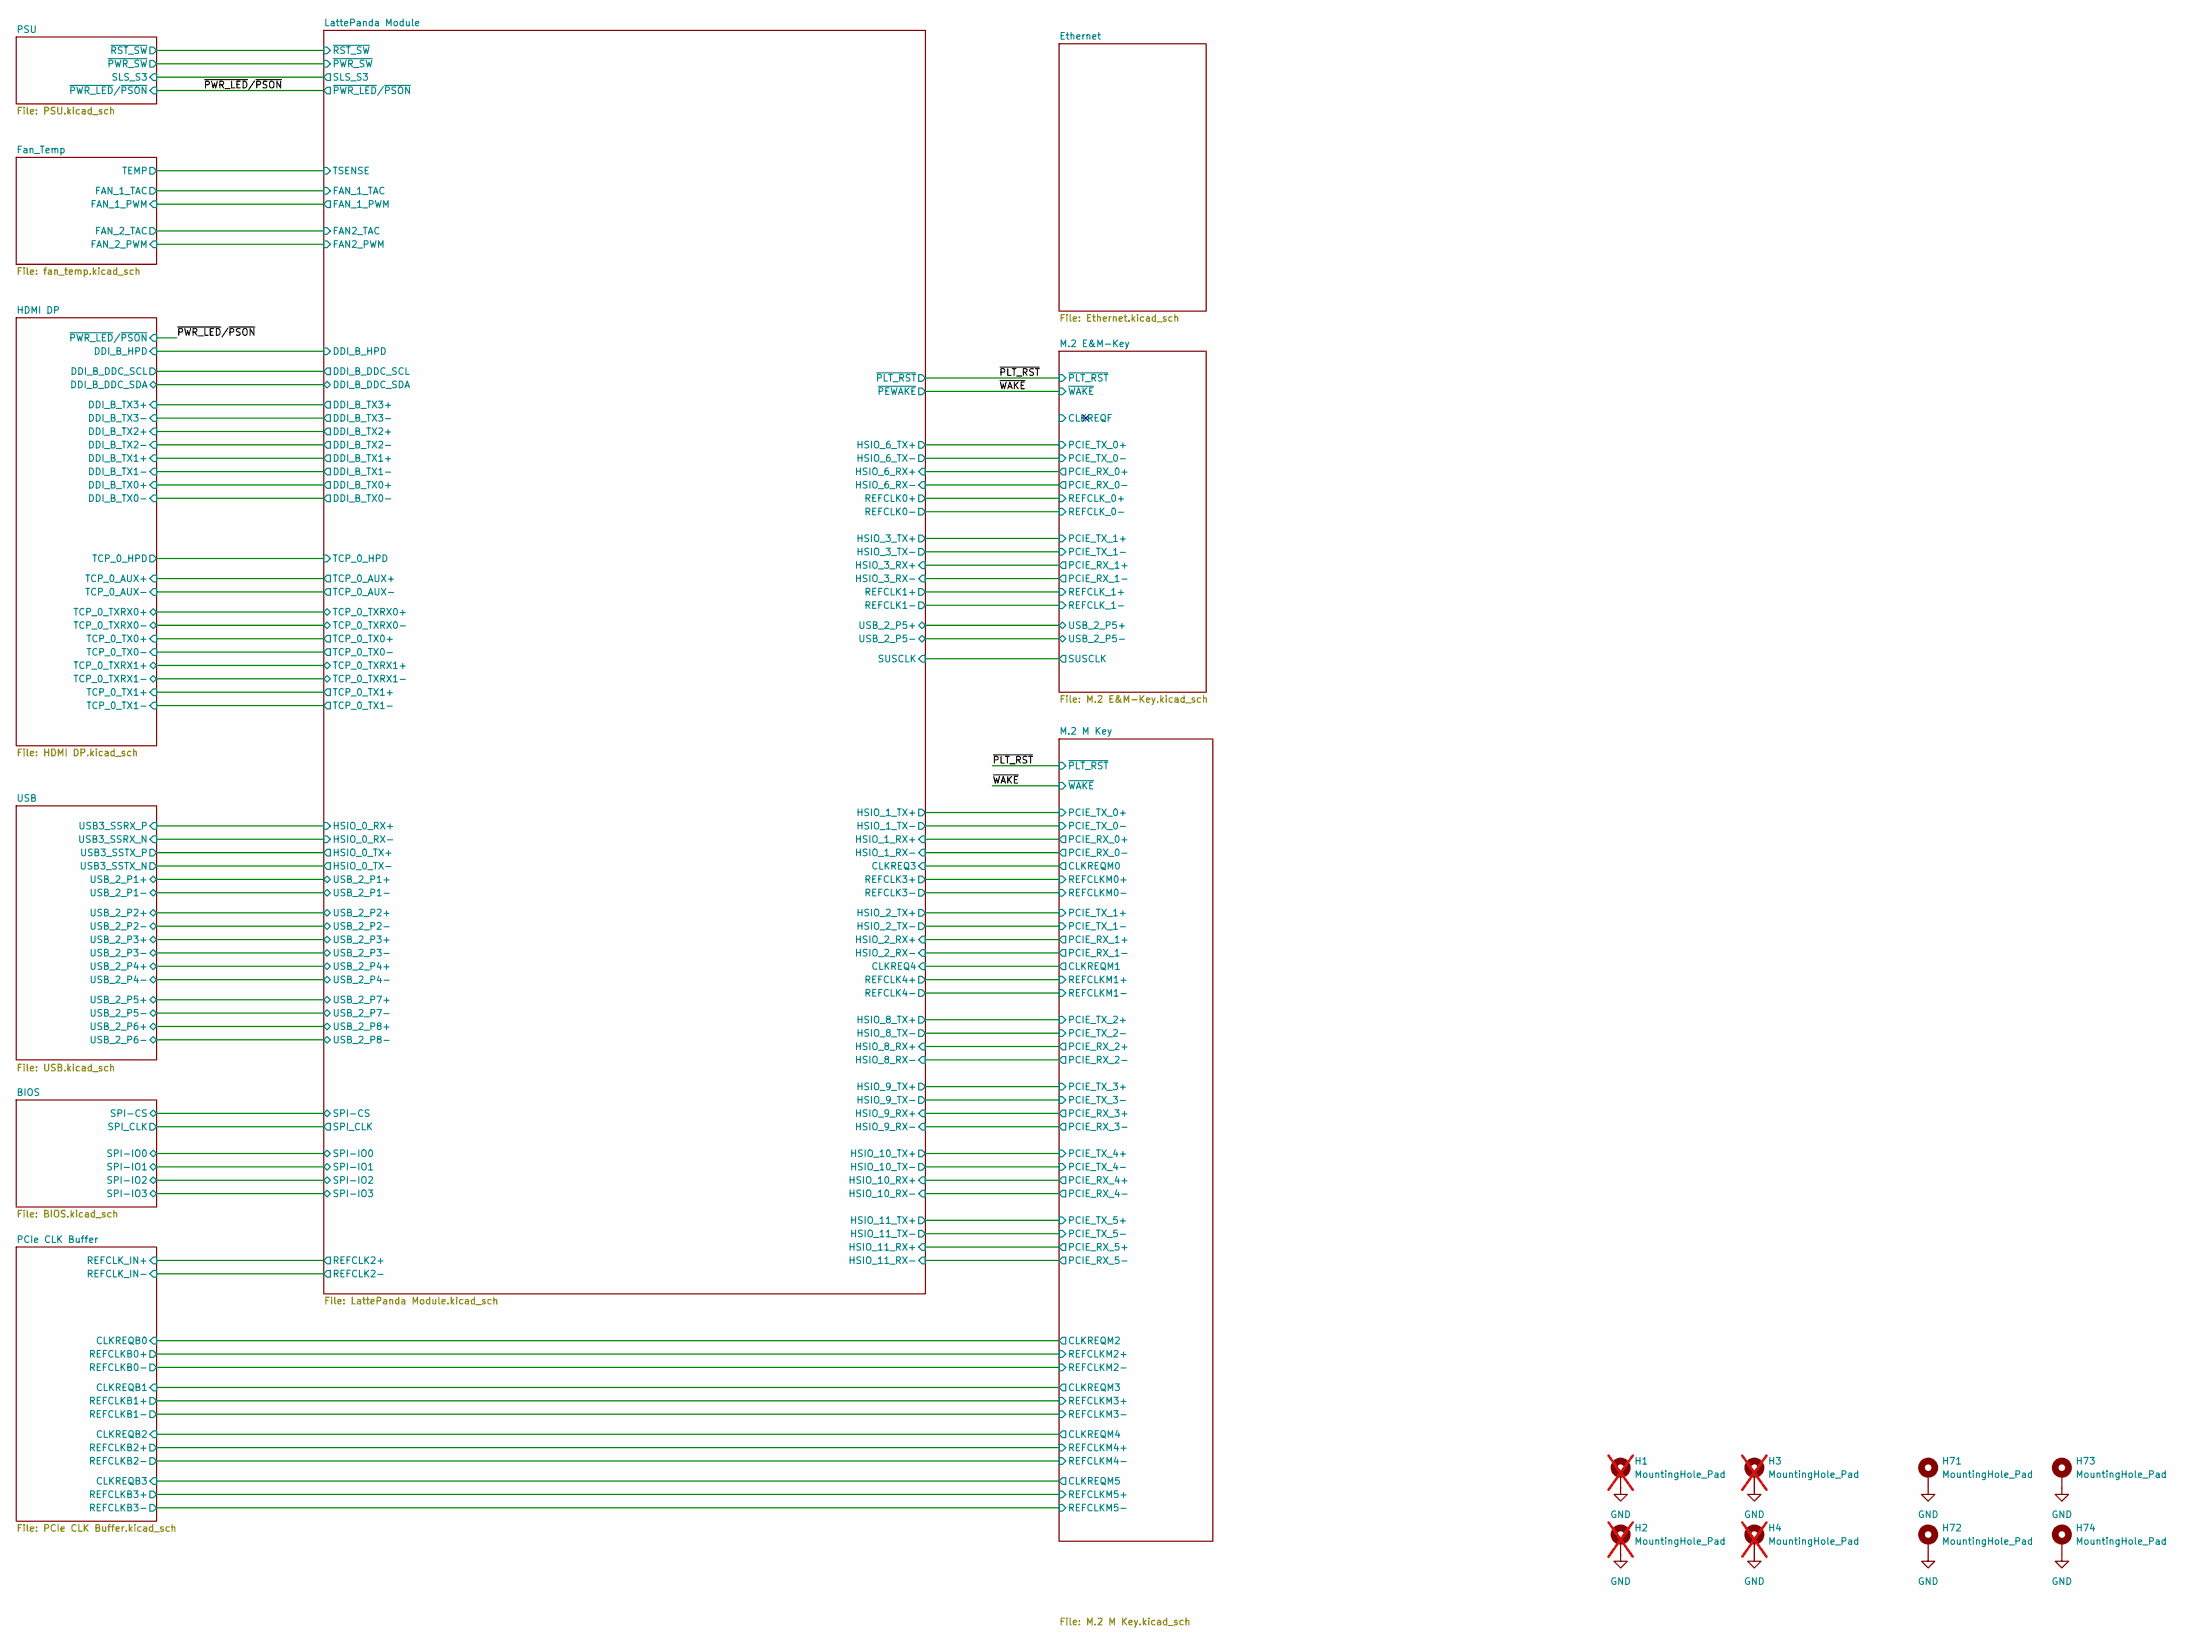
[picture p33: schematic nvme Carrier all M2.kicad_sch]

Parts:
H1, H2, H3, H4: MountingHole_Pad; MountingHole_3.2mm_M3_Pad_Via; not fitted
H71, H72, H73, H74: MountingHole_Pad; MountingHole_4mm_Pad_Via

Connections:
GND: H1.1, H2.1, H3.1, H4.1, H71.1, H72.1, H73.1, H74.1
