El-Luhb/nvme-Carrier-for-LattePanda-Mu/PCB/4 Layer nvme Carrier/PCIe.kicad_sch

## KiCad design PCB/4 Layer nvme Carrier/PCIe.kicad_sch (2025-01-31)

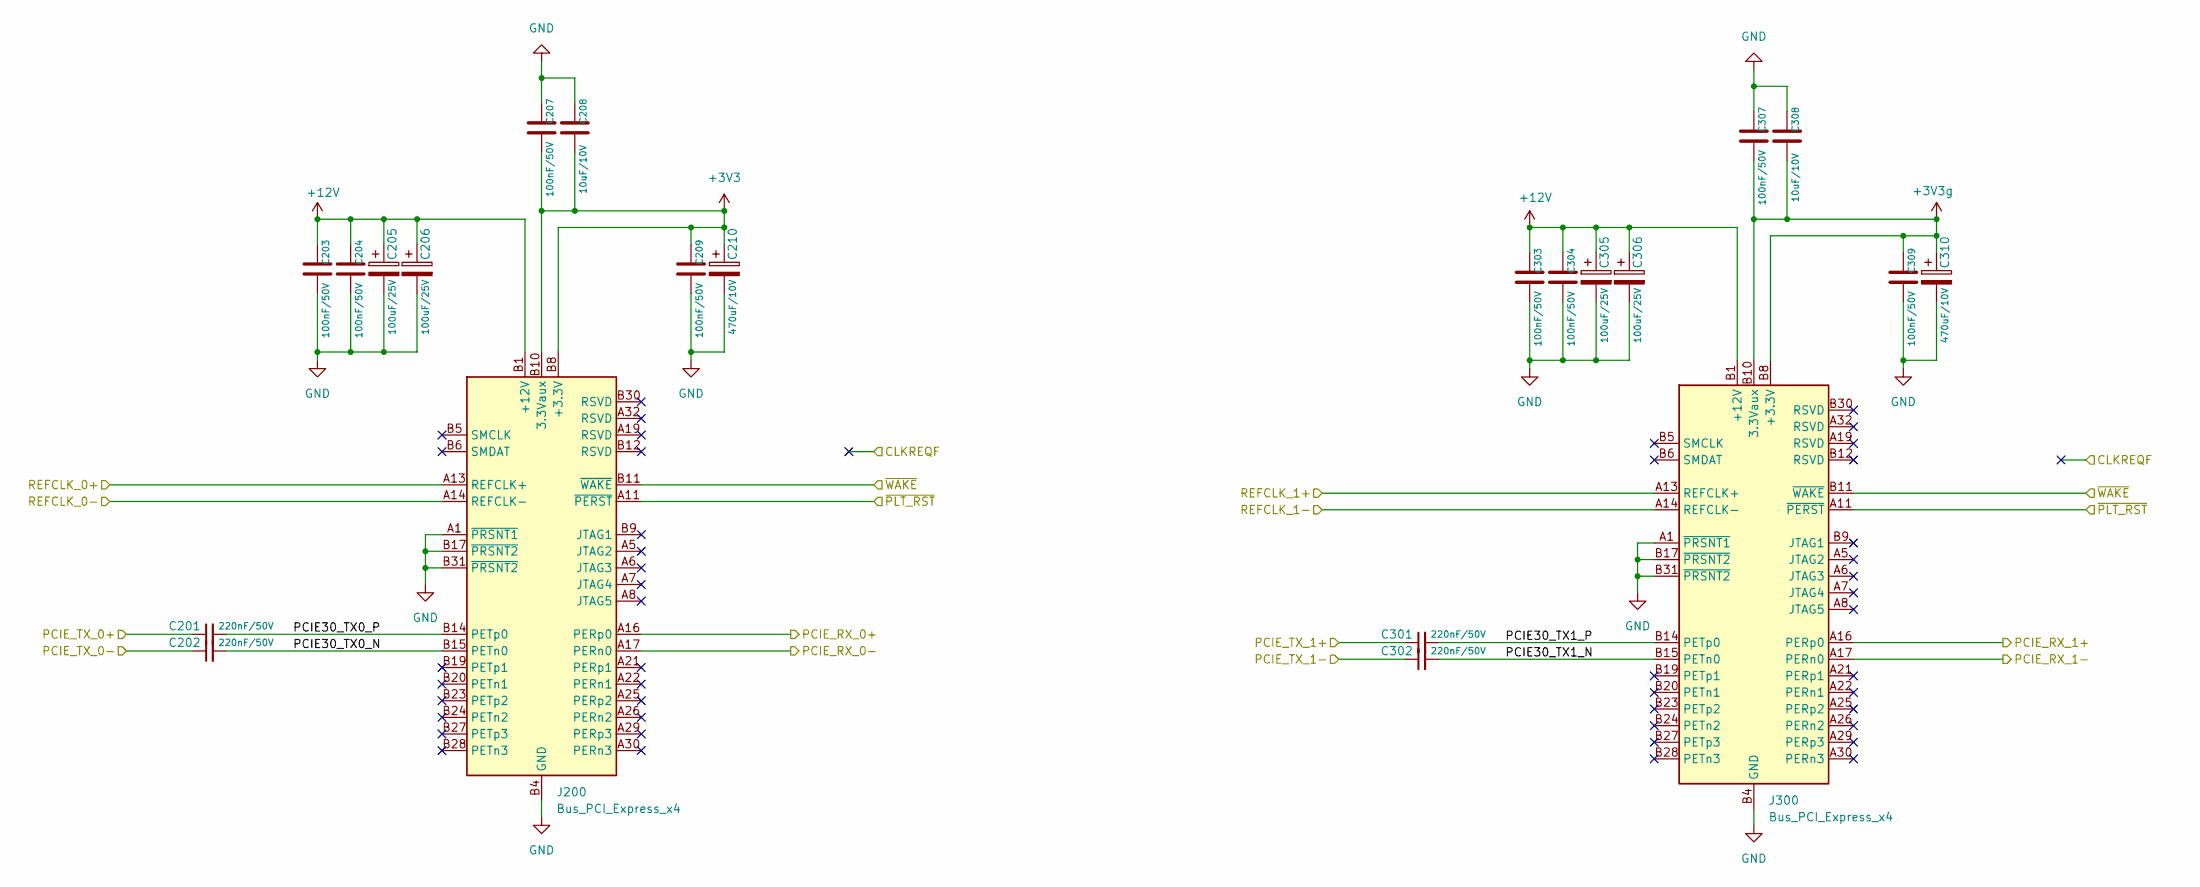
[picture p34: schematic PCIe.kicad_sch]

Parts:
C201, C202, C301, C302: 220nF/50V; C_0402_1005Metric; Part# C5159775; LCSC Part # C5159775
C203, C204, C207, C209, C303, C304, C307, C309: 100nF/50V; C_0402_1005Metric; Part# C77020; LCSC Part # C77020
C205, C206, C305, C306: 100uF/25V; CP_Elec_6.3x7.7; Part# C2886300; LCSC Part # C2886300
C208, C308: 10uF/10V; C_0402_1005Metric; Part# C315248; LCSC Part # C315248
C210, C310: 470uF/10V; CP_Elec_6.3x7.7; Part# C384654; LCSC Part # C384654
J200, J300: Bus_PCI_Express_x4; PCIe_x4_Gen3Slot_Connectors; Part# C2926855; LCSC Part # C2926855

Connections:
+3V3: C207.2, C208.2, C209.1, C210.1, J200.A9 (+3.3V), J200.A10 (+3.3V), J200.B8 (+3.3V), J200.B10 (3.3Vaux)
+3V3g: C307.2, C308.2, C309.1, C310.1, J300.A9 (+3.3V), J300.A10 (+3.3V), J300.B8 (+3.3V), J300.B10 (3.3Vaux)
+12V: C203.1, C204.1, C205.1, C206.1, C303.1, C304.1, C305.1, C306.1, J200.A2 (+12V), J200.A3 (+12V), J200.B1 (+12V), J200.B2 (+12V), J200.B3 (+12V), J300.A2 (+12V), J300.A3 (+12V), J300.B1 (+12V), J300.B2 (+12V), J300.B3 (+12V)
GND: C203.2, C204.2, C205.2, C206.2, C207.1, C208.1, C209.2, C210.2, C303.2, C304.2, C305.2, C306.2, C307.1, C308.1, C309.2, C310.2, J200.A1 (~PRSNT1), J200.A4 (GND), J200.A12 (GND), J200.A15 (GND), J200.A18 (GND), J200.A20 (GND), J200.A23 (GND), J200.A24 (GND), J200.A27 (GND), J200.A28 (GND), J200.A31 (GND), J200.B4 (GND), J200.B7 (GND), J200.B13 (GND), J200.B16 (GND), J200.B17 (~PRSNT2), J200.B18 (GND), J200.B21 (GND), J200.B22 (GND), J200.B25 (GND), J200.B26 (GND), J200.B29 (GND), J200.B31 (~PRSNT2), J200.B32 (GND), J300.A1 (~PRSNT1), J300.A4 (GND), J300.A12 (GND), J300.A15 (GND), J300.A18 (GND), J300.A20 (GND), J300.A23 (GND), J300.A24 (GND), J300.A27 (GND), J300.A28 (GND), J300.A31 (GND), J300.B4 (GND), J300.B7 (GND), J300.B13 (GND), J300.B16 (GND), J300.B17 (~PRSNT2), J300.B18 (GND), J300.B21 (GND), J300.B22 (GND), J300.B25 (GND), J300.B26 (GND), J300.B29 (GND), J300.B31 (~PRSNT2), J300.B32 (GND)
PCIE30_TX0_N: C202.2, J200.B15 (PETn0)
PCIE30_TX0_P: C201.2, J200.B14 (PETp0)
PCIE30_TX1_N: C302.2, J300.B15 (PETn0)
PCIE30_TX1_P: C301.2, J300.B14 (PETp0)
PCIE_RX_0+: J200.A16 (PERp0)
PCIE_RX_0-: J200.A17 (PERn0)
PCIE_RX_1+: J300.A16 (PERp0)
PCIE_RX_1-: J300.A17 (PERn0)
PCIE_TX_0+: C201.1
PCIE_TX_0-: C202.1
PCIE_TX_1+: C301.1
PCIE_TX_1-: C302.1
REFCLK_0+: J200.A13 (REFCLK+)
REFCLK_0-: J200.A14 (REFCLK-)
REFCLK_1+: J300.A13 (REFCLK+)
REFCLK_1-: J300.A14 (REFCLK-)
~PLT_RST: J200.A11 (~PERST), J300.A11 (~PERST)
~WAKE: J200.B11 (~WAKE), J300.B11 (~WAKE)
