El-Luhb/nvme-Carrier-for-LattePanda-Mu/(commit log)

2024-06-23 First Upload
    [HDMI.kicad_sch, LattePanda Module.kicad_sch, M.2 M Key.kicad_sch, PCIe.kicad_sch, PSU.kicad_sch, USB.kicad_sch, fan_temp.kicad_sch, nvme Carrier for LattePanda Mu.kicad_sch]
2024-06-25 Parts change for BOM
    [HDMI.kicad_sch, LattePanda Module.kicad_sch, M.2 M Key.kicad_sch, PCIe.kicad_sch, PSU.kicad_sch, USB.kicad_sch, fan_temp.kicad_sch, nvme Carrier for LattePanda Mu.csv]
2024-07-13 BOM update and pdf
    [HDMI.kicad_sch, LattePanda Module.kicad_sch, M.2 M Key.kicad_sch, PCIe.kicad_sch, PSU.kicad_sch, USB.kicad_sch, fan_temp.kicad_sch, nvme Carrier for LattePanda Mu.csv]
2024-07-17 Rework for PSU and REFCLK
    [LattePanda Module.kicad_sch, M.2 M Key.kicad_sch, PSU.kicad_sch, nvme Carrier for LattePanda Mu.kicad_sch]
2024-07-19 change to 12V and more work to do
    [LattePanda Module.kicad_sch, PCIe.kicad_sch, PSU.kicad_sch, fan_temp.kicad_sch]
2024-08-18 Add new Buffer Chip for rework
    [LattePanda Module.kicad_sch]
2024-08-19 Rework started with PCIe
    [BIOS.kicad_sch, HDMI.kicad_sch, LattePanda Module.kicad_sch, M.2 M Key.kicad_sch, PCIe CLK Buffer.kicad_sch, PCIe.kicad_sch, PSU.kicad_sch, USB.kicad_sch]
2024-08-21 PCIe and CLK Buffenr Lines
    [BIOS.kicad_sch, HDMI.kicad_sch, LattePanda Module.kicad_sch, M.2 M Key.kicad_sch, PCIe CLK Buffer.kicad_sch, PCIe.kicad_sch, PSU.kicad_sch, USB.kicad_sch]
2024-08-22 change to 4 Layer - 2 Layer later if possible
    [BIOS.kicad_sch, HDMI.kicad_sch, LattePanda Module.kicad_sch, M.2 M Key.kicad_sch, PCIe CLK Buffer.kicad_sch, PCIe.kicad_sch, PSU.kicad_sch, USB.kicad_sch]
2024-08-23 wrong Partnumber for the 33R
    [PCIe CLK Buffer.kicad_sch]
2024-09-19 Silk and BOM changes
    [BIOS.kicad_sch, HDMI.kicad_sch, LattePanda Module.kicad_sch, M.2 M Key.kicad_sch, PCIe CLK Buffer.kicad_sch, PCIe.kicad_sch, PSU.kicad_sch, USB.kicad_sch]
2024-09-19 add jpg of the Prototype
2024-09-19 USB 3 listed in BOM
    [USB.kicad_sch, nvme Carrier for LattePanda Mu.csv]
2024-11-07 Add example Carrier Case
    [nvme Carrier Case.STL]
2024-12-30 Update STL files for the Case
    [nvme Carrier Case Bottom.STL, nvme Carrier Case Top.STL, nvme Carrier Case.STL]
2025-01-30 Fix USB3.2. And Updated some C
    Fix USB3.2 Error (twisted Tx and Rx). And Updated some C from 22uF/10V to 22uF/16V
    [BIOS.kicad_sch, HDMI.kicad_sch, LattePanda Module.kicad_sch, M.2 M Key.kicad_sch, PCIe CLK Buffer.kicad_sch, PCIe.kicad_sch, PSU.kicad_sch, USB.kicad_sch]
2025-01-30 Fixed Fix for USB3.2
    [nvme Carrier for LattePanda Mu.kicad_sch]
2025-01-31 new JPG, new 3V3 names and del the M.2 60mm mounts
    [M.2 M Key.kicad_sch, PCIe.kicad_sch, PSU.kicad_sch, fan_temp.kicad_sch]
2025-01-31 LED 3V3x rename
    [M.2 M Key.kicad_sch]
2025-02-01 first all M.2 try
    [BIOS.kicad_sch, Ethernet.kicad_sch, HDMI DP.kicad_sch, HDMI.kicad_sch, LattePanda Module.kicad_sch, M.2 E&M-Key.kicad_sch, M.2 M Key.kicad_sch, PCIe CLK Buffer.kicad_sch]
2025-02-06 first all-M.2 version
    [BIOS.kicad_sch, Ethernet.kicad_sch, HDMI DP.kicad_sch, LattePanda Module.kicad_sch, M.2 E&M-Key.kicad_sch, M.2 M Key.kicad_sch, PCIe CLK Buffer.kicad_sch, PSU.kicad_sch]
2025-02-06 Edit README for all-M.2 and add JPG
    [PSU.kicad_sch]
